mhyrzt/agentronics/README.md

# agentronics
Revisiting electronics and embedded systems with old sparks, new circuits, questionable ideas, and a few AI agents running around the lab with a suspicious amount of confidence.
