mhyrzt/agentronics/EEG/exports/previews/controller-header.png

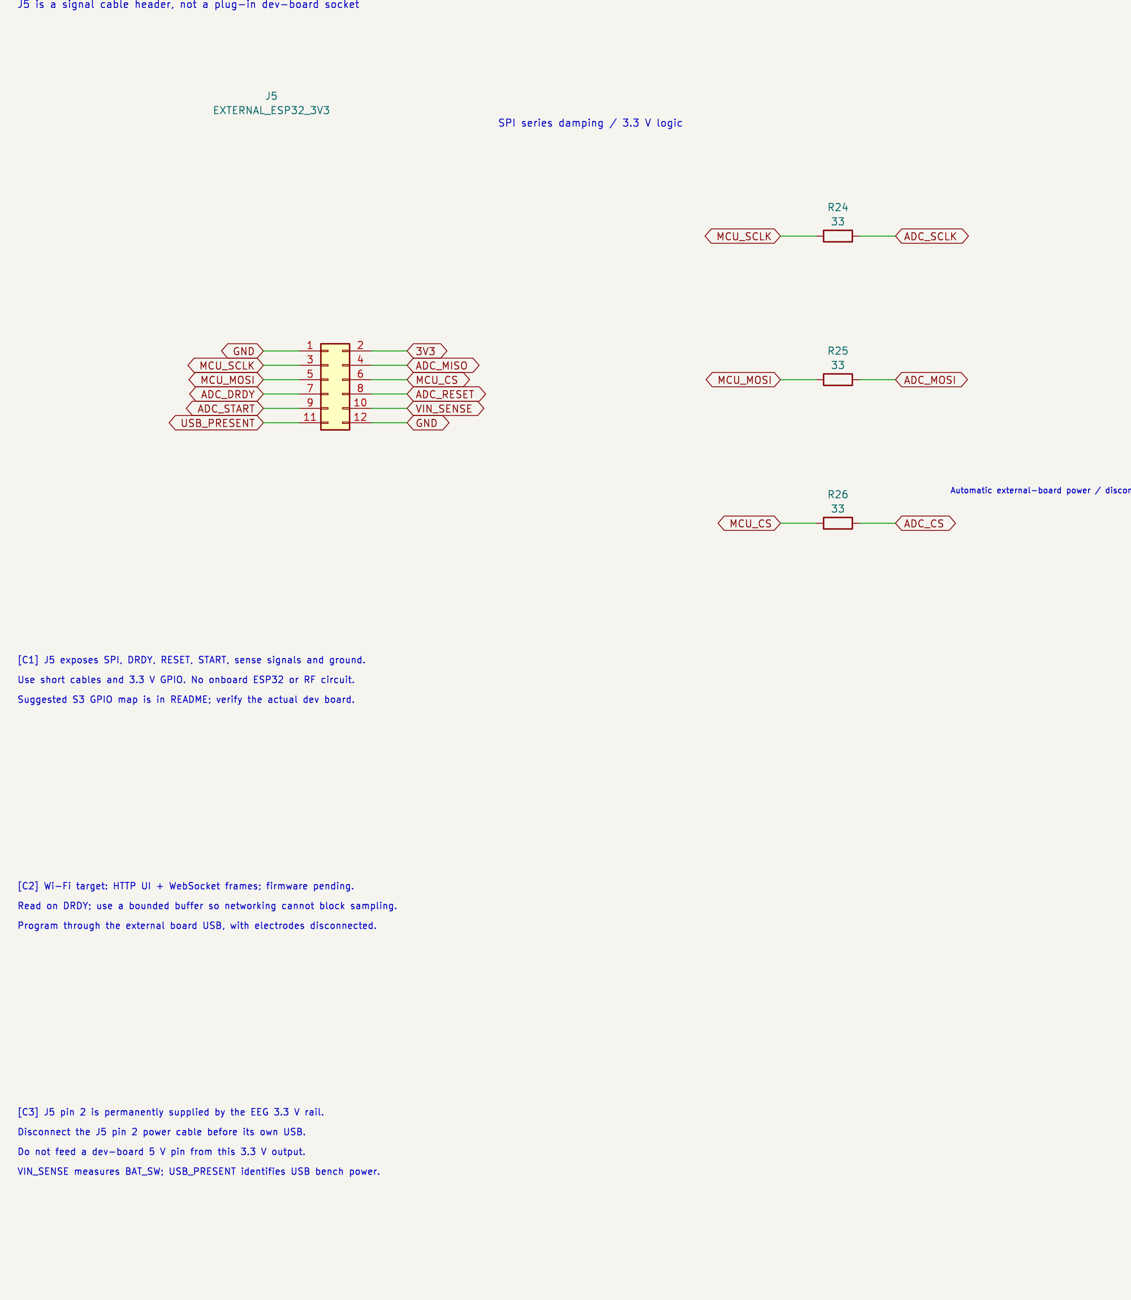
EEG/exports/previews/controller-header.png
