mhyrzt/agentronics/EEG/exports/previews/pcb-bottom.png

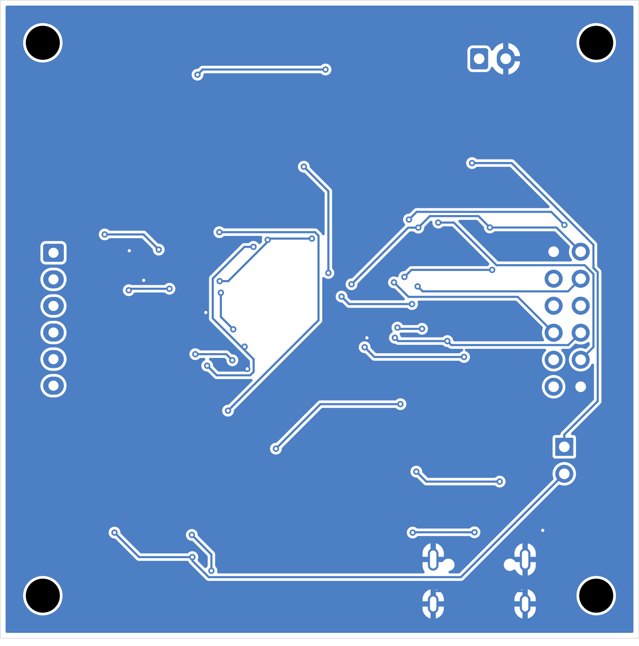
EEG/exports/previews/pcb-bottom.png
