mhyrzt/agentronics/EEG/exports/previews/pcb-top.png

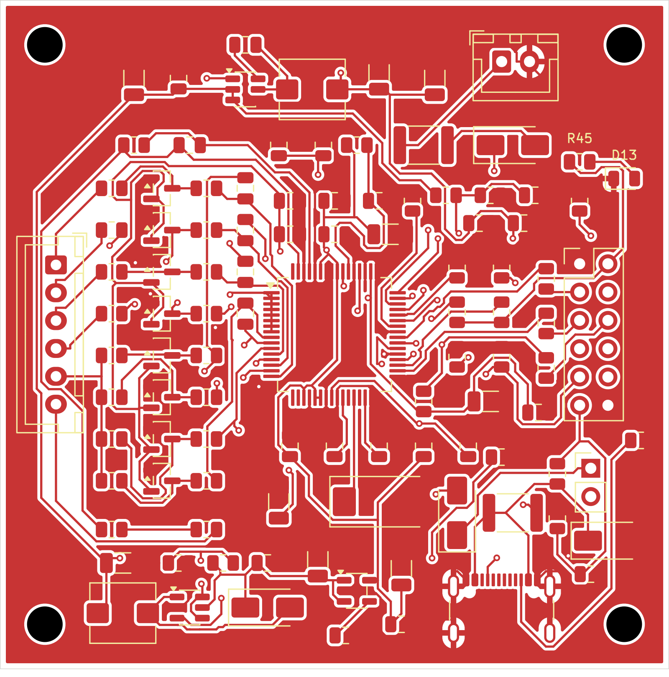
EEG/exports/previews/pcb-top.png
