mhyrzt/agentronics/EEG/exports/BOM.csv

References | Quantity | Value | Footprint | MPN | Manufacturer
C5 | 1 | 1n | Capacitor_SMD:C_0805_2012Metric | GRM21A5C1H102JA01D | Murata
C6 | 1 | 100u | Capacitor_Tantalum_SMD:CP_EIA-7343-31_Kemet-D | T491D107K010AT | KEMET
C34 | 1 | 10n | Capacitor_SMD:C_0805_2012Metric | GRM21A5C1H103JA01D | Murata
C1,C2,C3,C4 | 4 | 4.7n | Capacitor_SMD:C_0805_2012Metric | GRM21A5C1H472JA01D | Murata
C11,C19,C24,C28,C33,C35,C37 | 7 | 10u | Capacitor_SMD:C_1206_3216Metric | GRM31CR71C106KA12L | Murata
C31,C32 | 2 | 22u | Capacitor_SMD:C_1206_3216Metric | GRM31CR61E226KE15L | Murata
C10,C13,C14,C15,C16,C17,C18,C21,C38,C7,C8 | 11 | 1u | Capacitor_SMD:C_0805_2012Metric | GRM21BR71E105KA99L | Murata
C12,C20,C22,C25,C27,C29,C30,C36,C40,C9 | 10 | 100n | Capacitor_SMD:C_0805_2012Metric | GRM21BR71H104KA01L | Murata
D12 | 1 | SMAJ5.0A | Diode_SMD:D_SMA | SMAJ5.0A | Diodes Incorporated
D13 | 1 | PWR_GREEN | LED_SMD:LED_0805_2012Metric | APT2012LZGCK | Kingbright
D1,D2,D3,D4,D5,D7,D8,D9 | 8 | BAV199 | Package_TO_SOT_SMD:SOT-23 | BAV199,215 | Nexperia
D10,D11,D6 | 3 | SS14 | Diode_SMD:D_SMA | SS14 | Diodes Incorporated
F1,F2 | 2 | 0.75A_PTC | Fuse:Fuse_1812_4532Metric | 1812L075/24DR | Littelfuse
J1 | 1 | ELECTRODES | Connector_JST:JST_XH_B6B-XH-A_1x06_P2.50mm_Vertical | B6B-XH-A | JST
J2 | 1 | 2S_BATTERY | Connector_JST:JST_XH_B2B-XH-A_1x02_P2.50mm_Vertical | B2B-XH-A | JST
J4 | 1 | POWER_ENABLE | Connector_PinHeader_2.54mm:PinHeader_1x02_P2.54mm_Vertical | 61300211121 | Wurth Elektronik
J5 | 1 | EXTERNAL_ESP32_3V3 | Connector_PinHeader_2.54mm:PinHeader_2x06_P2.54mm_Vertical | 61301221121 | Wurth Elektronik
J6 | 1 | USB_C_BENCH_POWER | Connector_USB:USB_C_Receptacle_GCT_USB4105-xx-A_16P_TopMnt_Horizontal | USB4105-GF-A | GCT
L1,L2 | 2 | 4.7uH | Inductor_SMD:L_Bourns_SRP5030T | SRP5030T-4R7M | Bourns
R13 | 1 | 1M | Resistor_SMD:R_0805_2012Metric | RC0805FR-071ML | Yageo
R14 | 1 | 0 | Resistor_SMD:R_0805_2012Metric | RC0805JR-070RL | Yageo
R41 | 1 | 442k | Resistor_SMD:R_0805_2012Metric | RC0805FR-07442KL | Yageo
R45 | 1 | 1k | Resistor_SMD:R_0805_2012Metric | RC0805FR-071KL | Yageo
R1,R10,R19,R2,R20,R23,R3,R33,R34,R35,R36,R37,R38,R4,R42,R5,R6,R7,R8,R9 | 20 | 10k | Resistor_SMD:R_0805_2012Metric | RC0805FR-0710KL | Yageo
R11,R12 | 2 | 499k | Resistor_SMD:R_0805_2012Metric | RC0805FR-07499KL | Yageo
R15,R16,R17,R18,R21,R22,R32,R44 | 8 | 100k | Resistor_SMD:R_0805_2012Metric | RC0805FR-07100KL | Yageo
R24,R25,R26 | 3 | 33 | Resistor_SMD:R_0805_2012Metric | RC0805FR-0733RL | Yageo
R31,R43 | 2 | 330k | Resistor_SMD:R_0805_2012Metric | RC0805FR-07330KL | Yageo
R39,R40 | 2 | 5.1k | Resistor_SMD:R_0805_2012Metric | RC0805FR-075K1L | Yageo
U1 | 1 | ADS1299-4 | Package_QFP:TQFP-64_10x10mm_P0.5mm | ADS1299-4PAG | Texas Instruments
U3 | 1 | AP63203WU-7 | Package_TO_SOT_SMD:TSOT-23-6 | AP63203WU-7 | Diodes Incorporated
U4 | 1 | LP2985AIM5-5.0/NOPB | Package_TO_SOT_SMD:SOT-23-5 | LP2985AIM5-5.0/NOPB | Texas Instruments
U5 | 1 | AP3031KTR-G1 | Package_TO_SOT_SMD:SOT-23-6 | AP3031KTR-G1 | Diodes Incorporated
