mhyrzt/agentronics/EEG/exports/previews/pcb-assembly.png

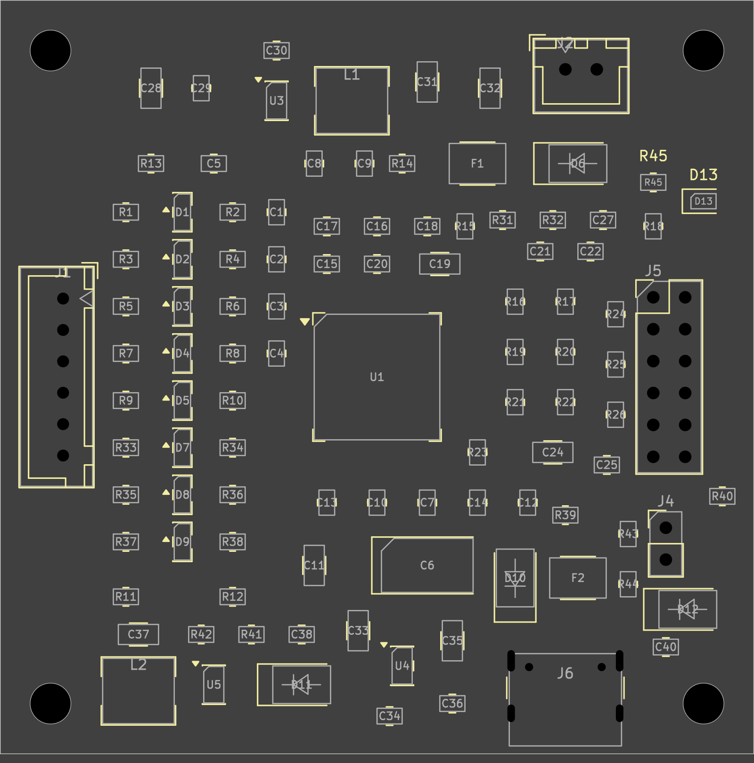
EEG/exports/previews/pcb-assembly.png
