mhyrzt/agentronics/EEG/exports/schematic.pdf

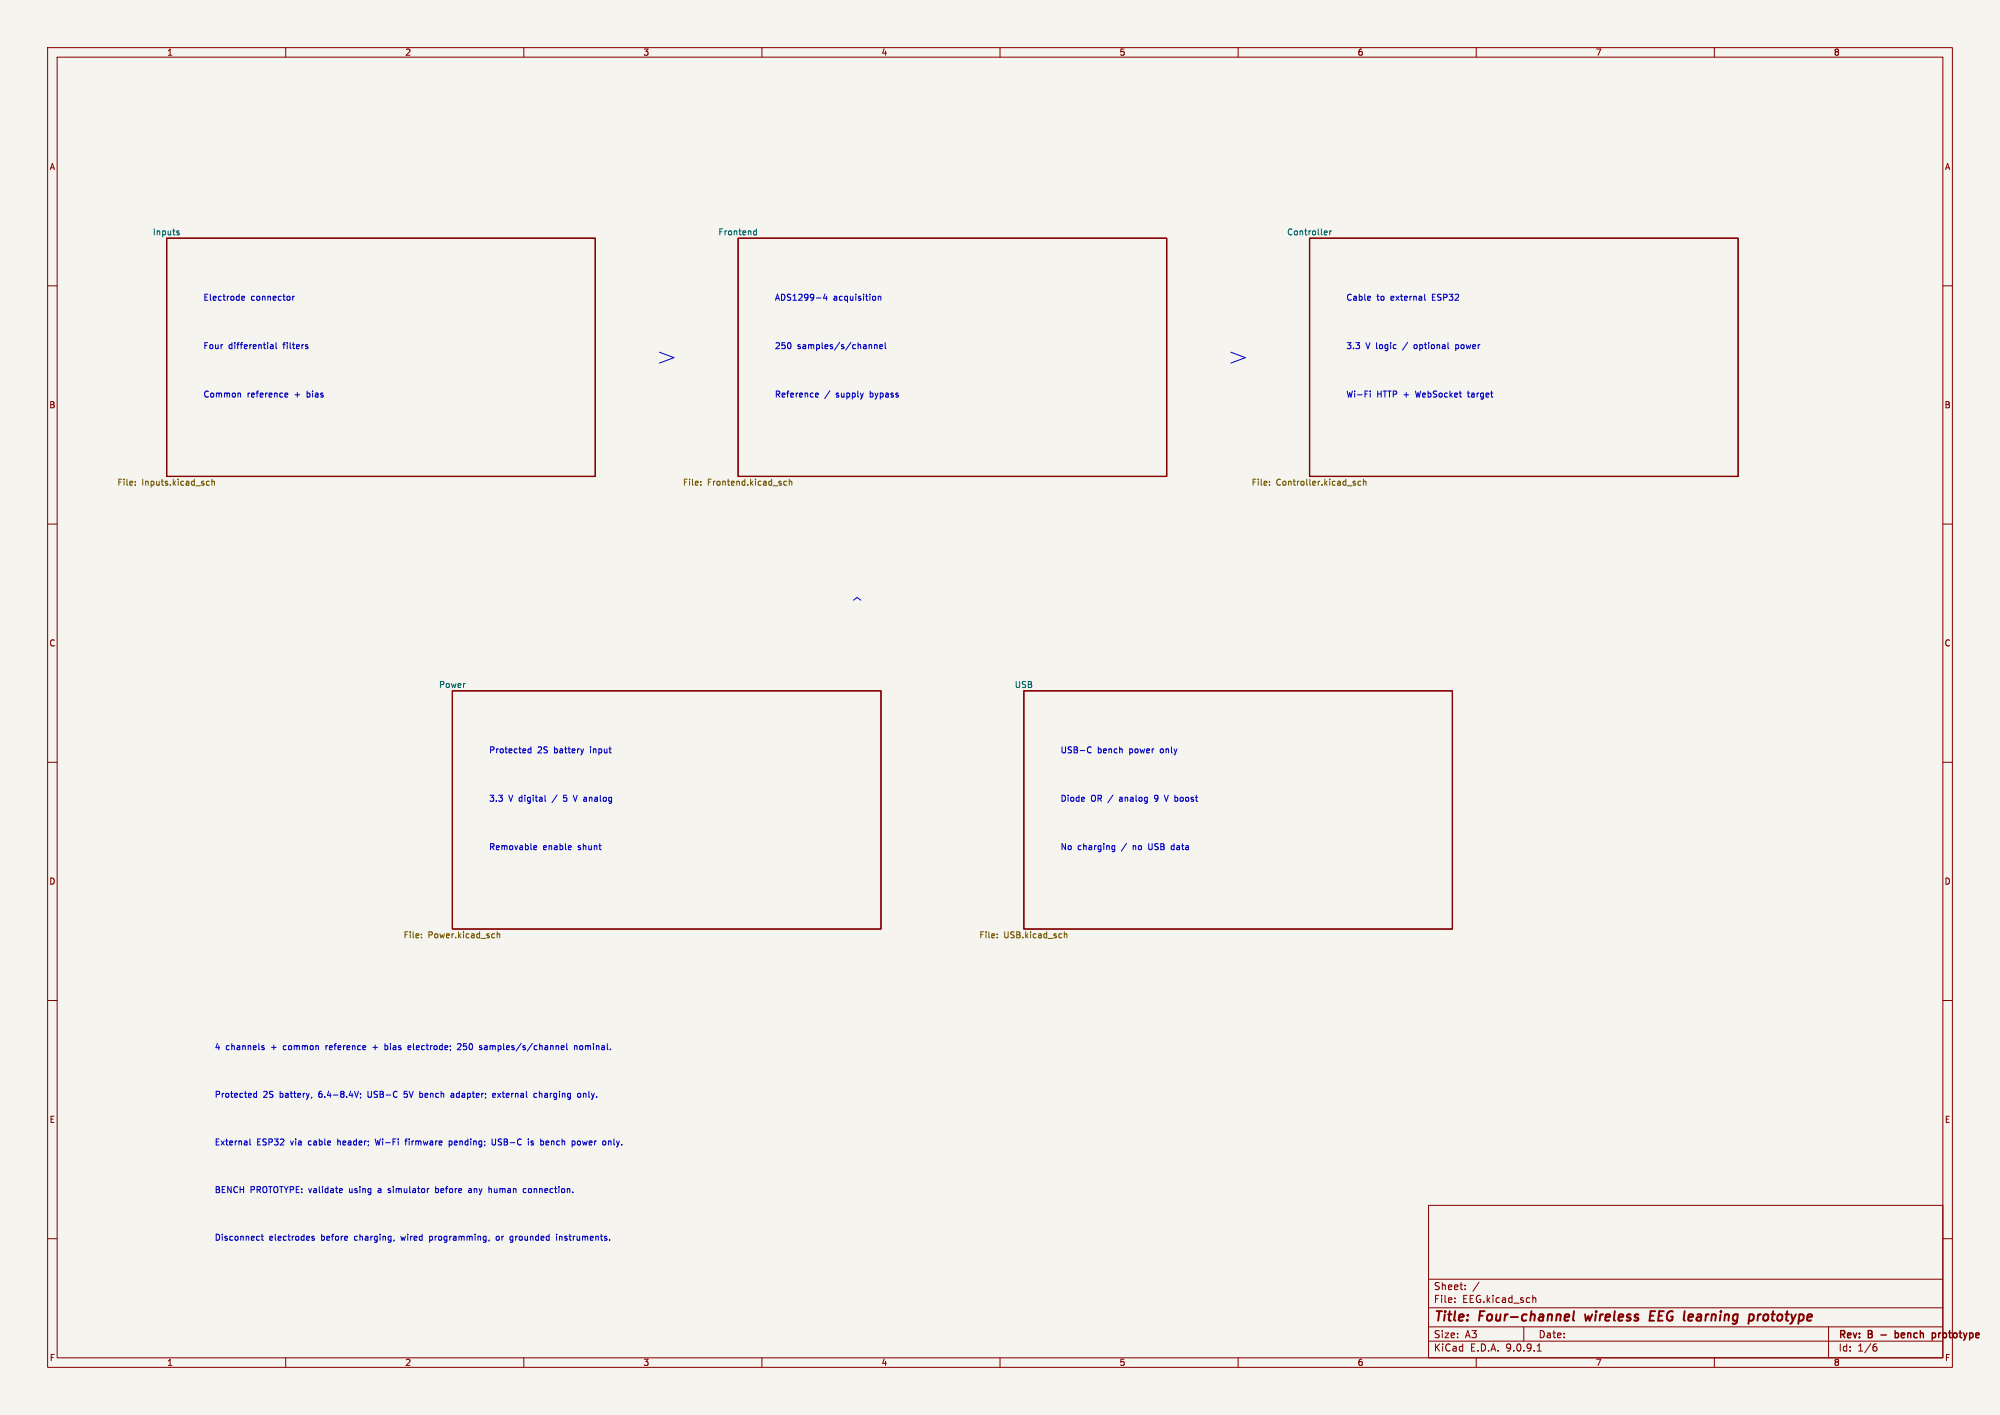
[picture p20: page 1]

File: USB.kicad_sch Power File: Power.kicad_sch

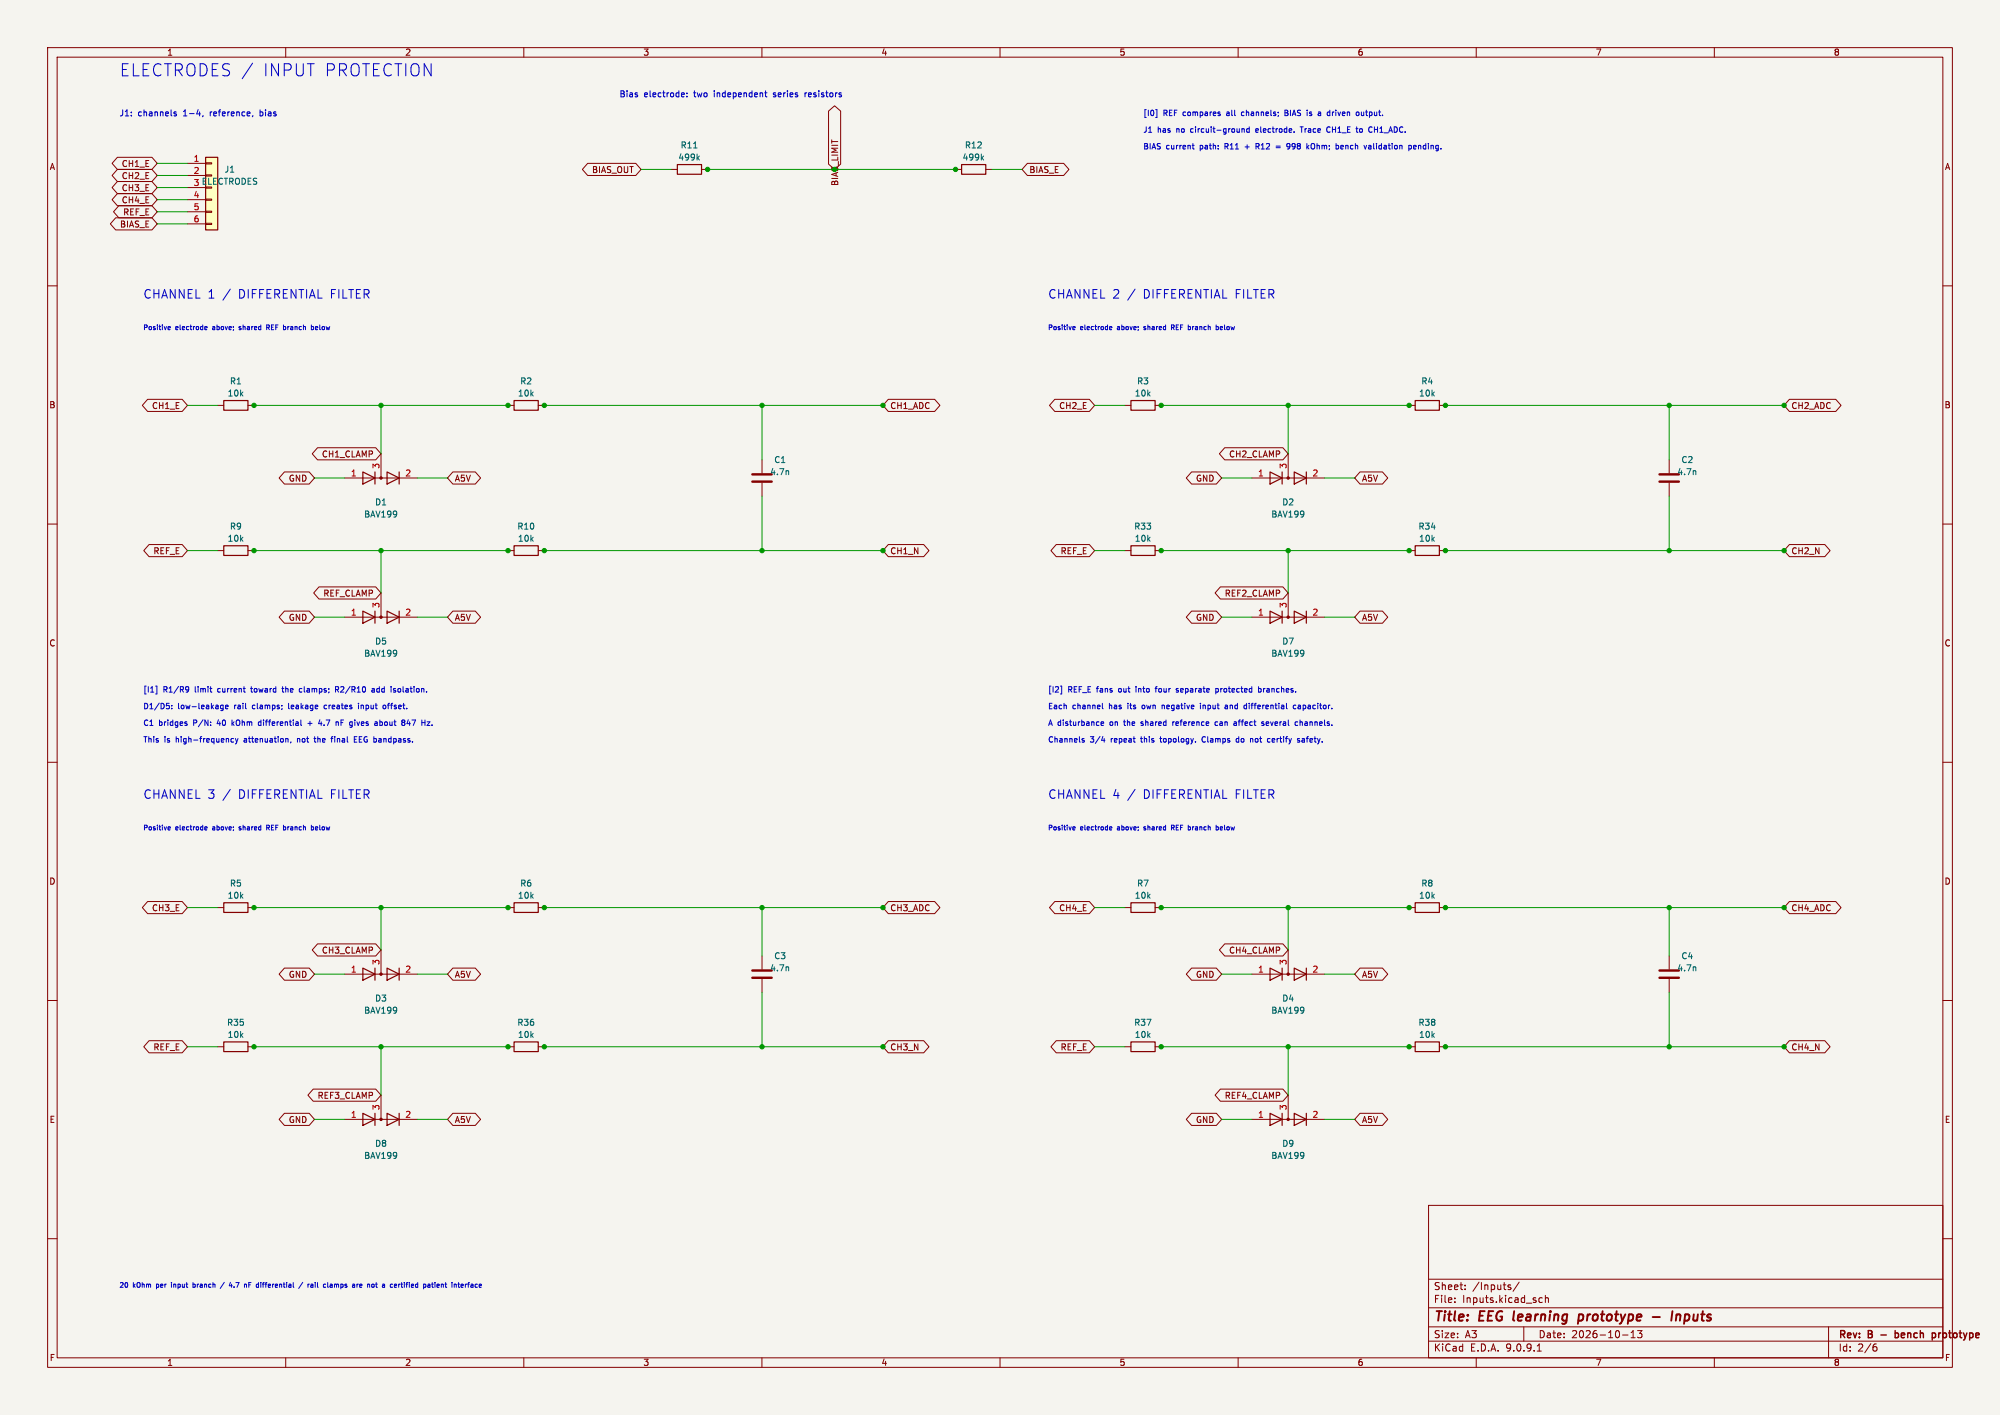
[picture p21: page 2]

Id: 2/6 Title: EEG learning prototype - Inputs

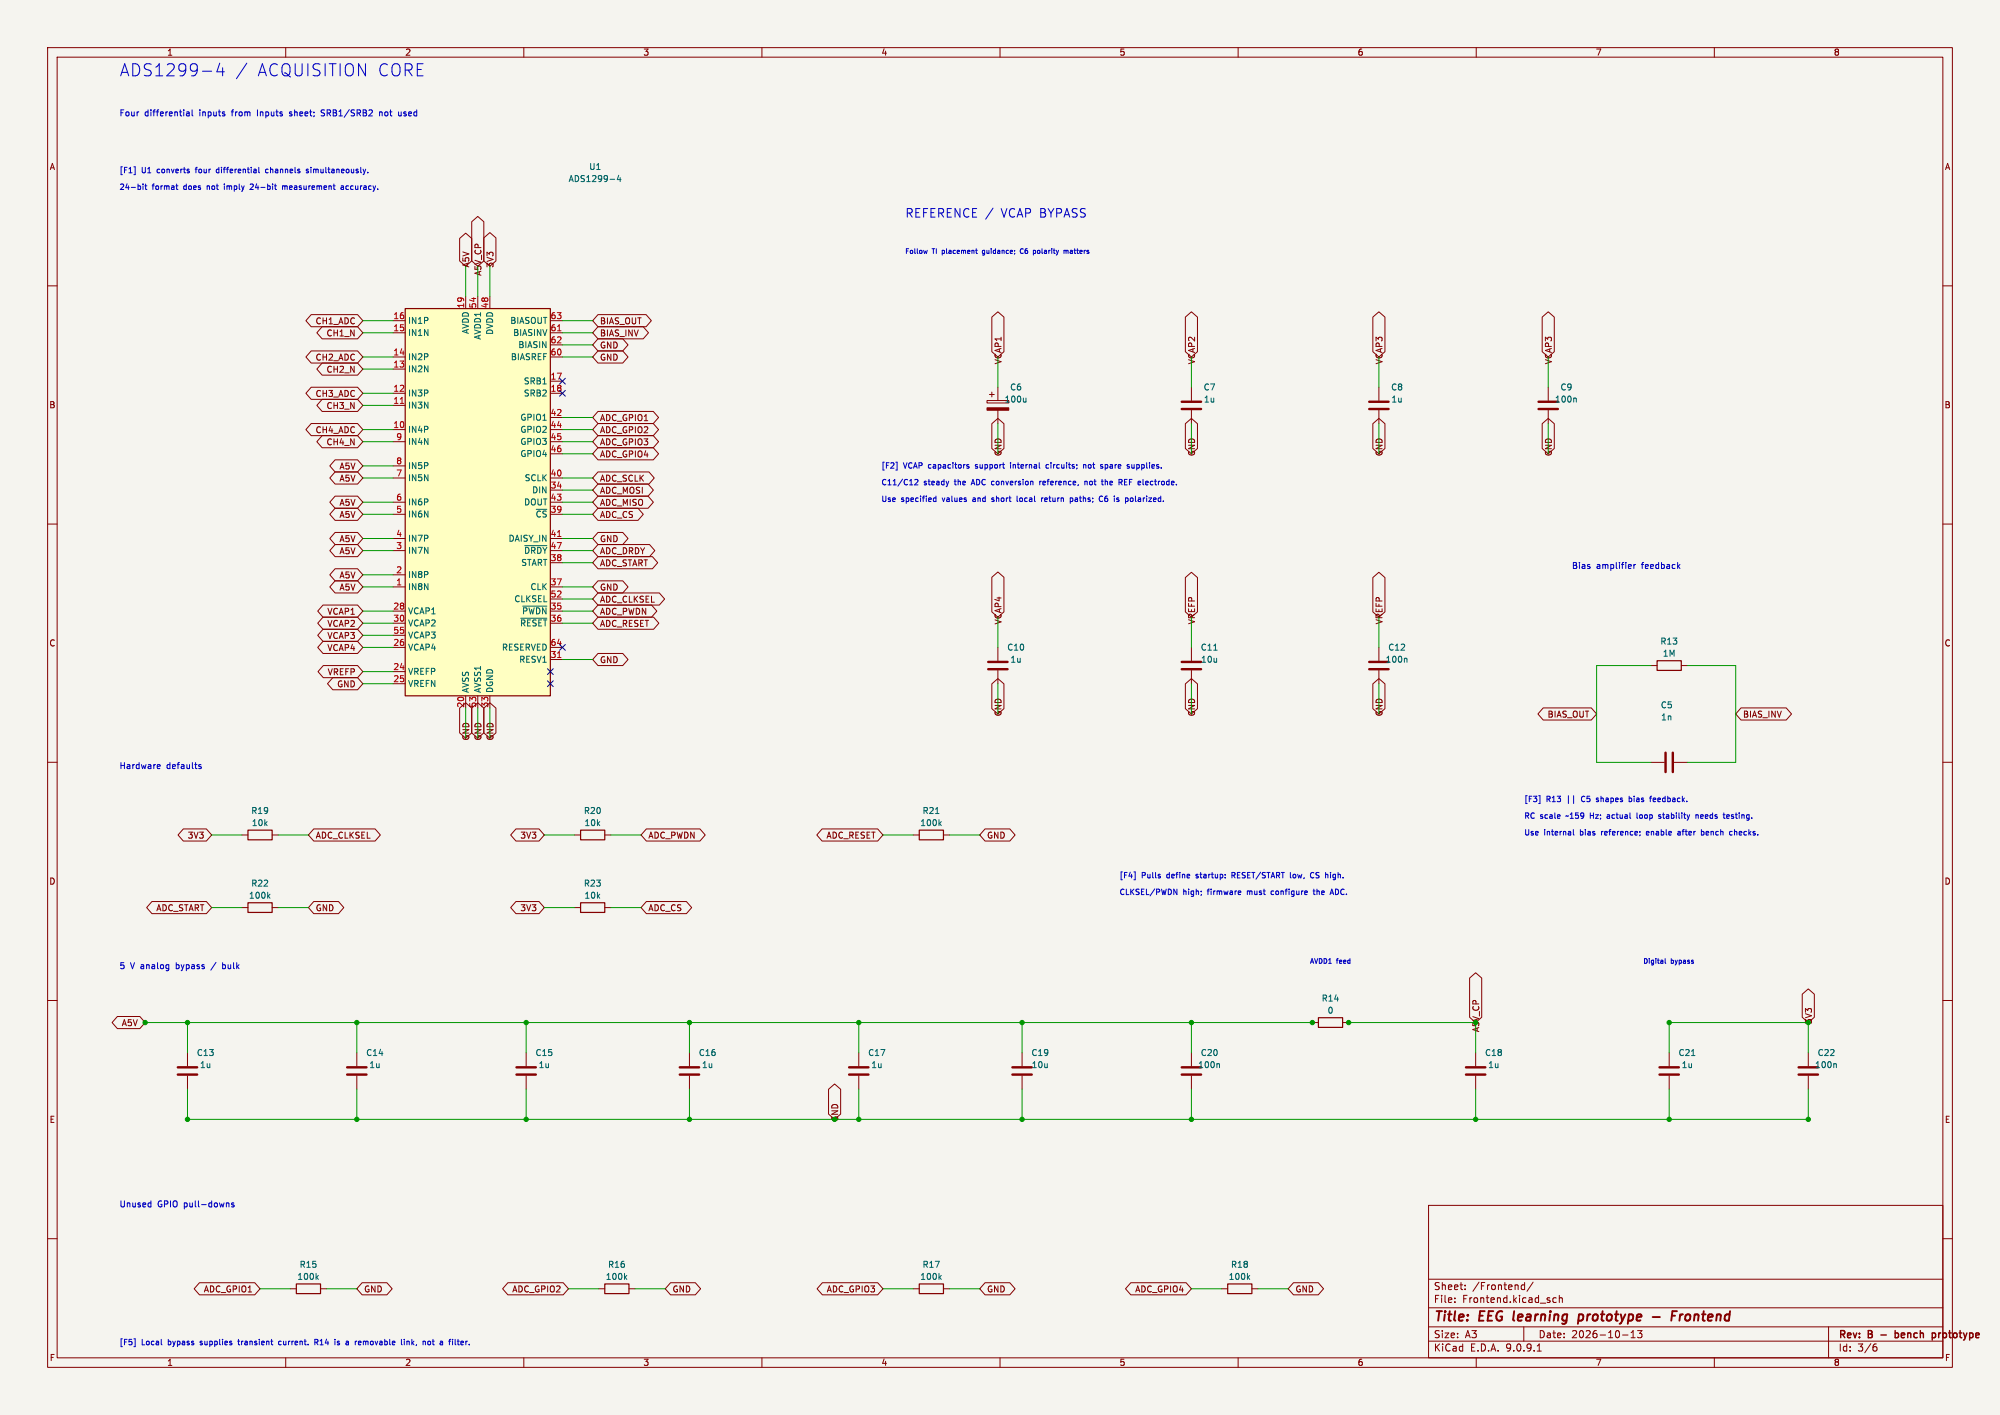
[picture p22: page 3]

Unused GPIO pull-downs

Id: 3/6 Title: EEG learning prototype - Frontend

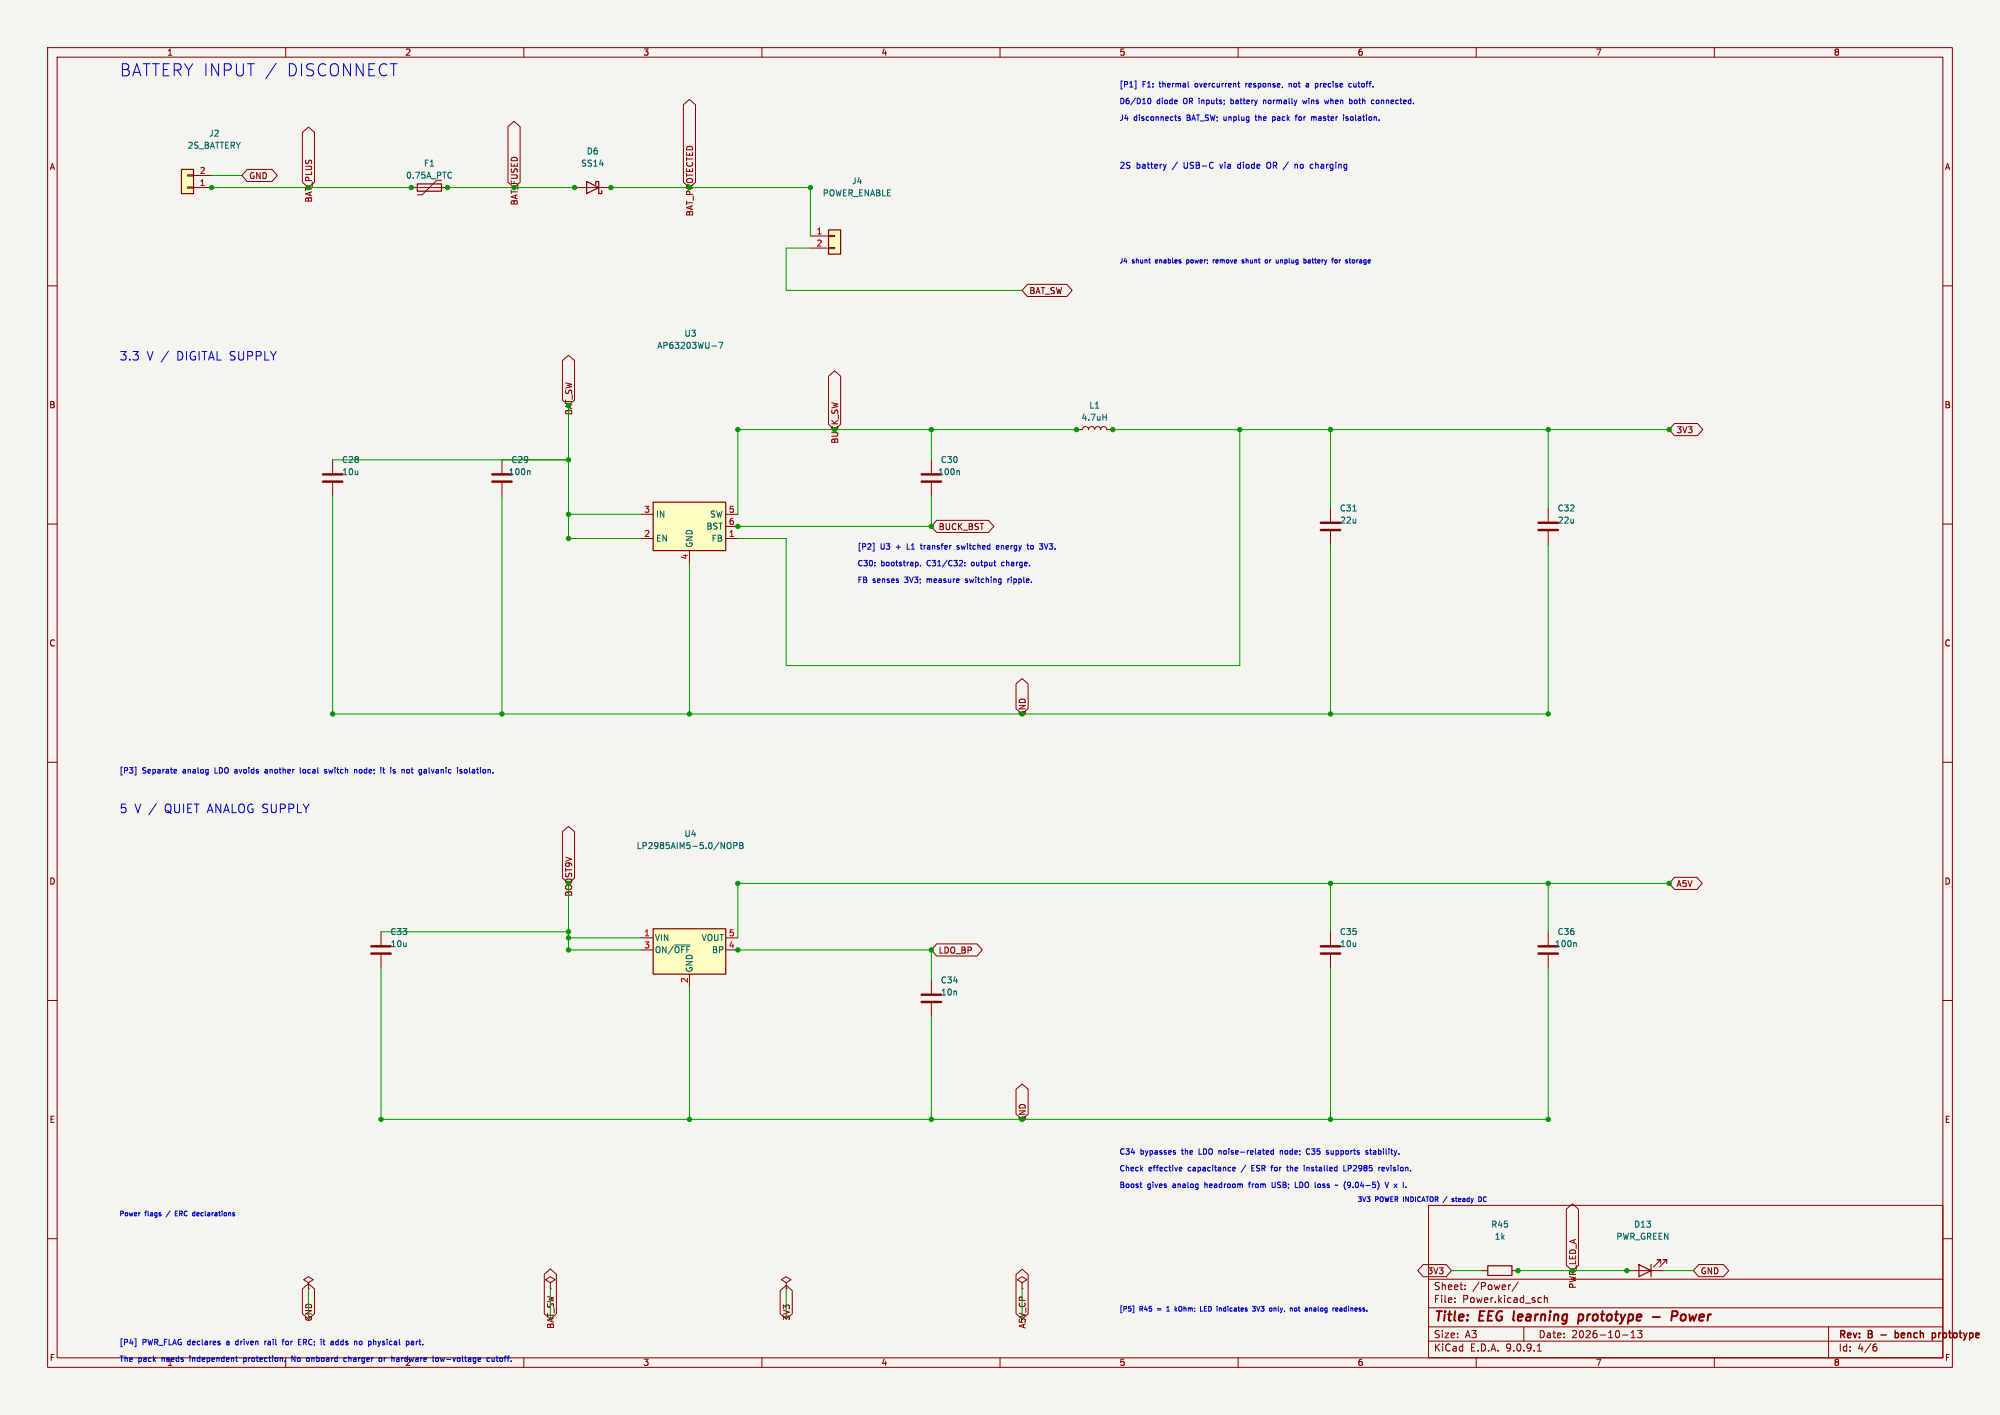
[picture p23: page 4]

2S battery / USB-C via diode OR / no charging

J4 shunt enables power; remove shunt or unplug battery for storage

Power flags / ERC declarations

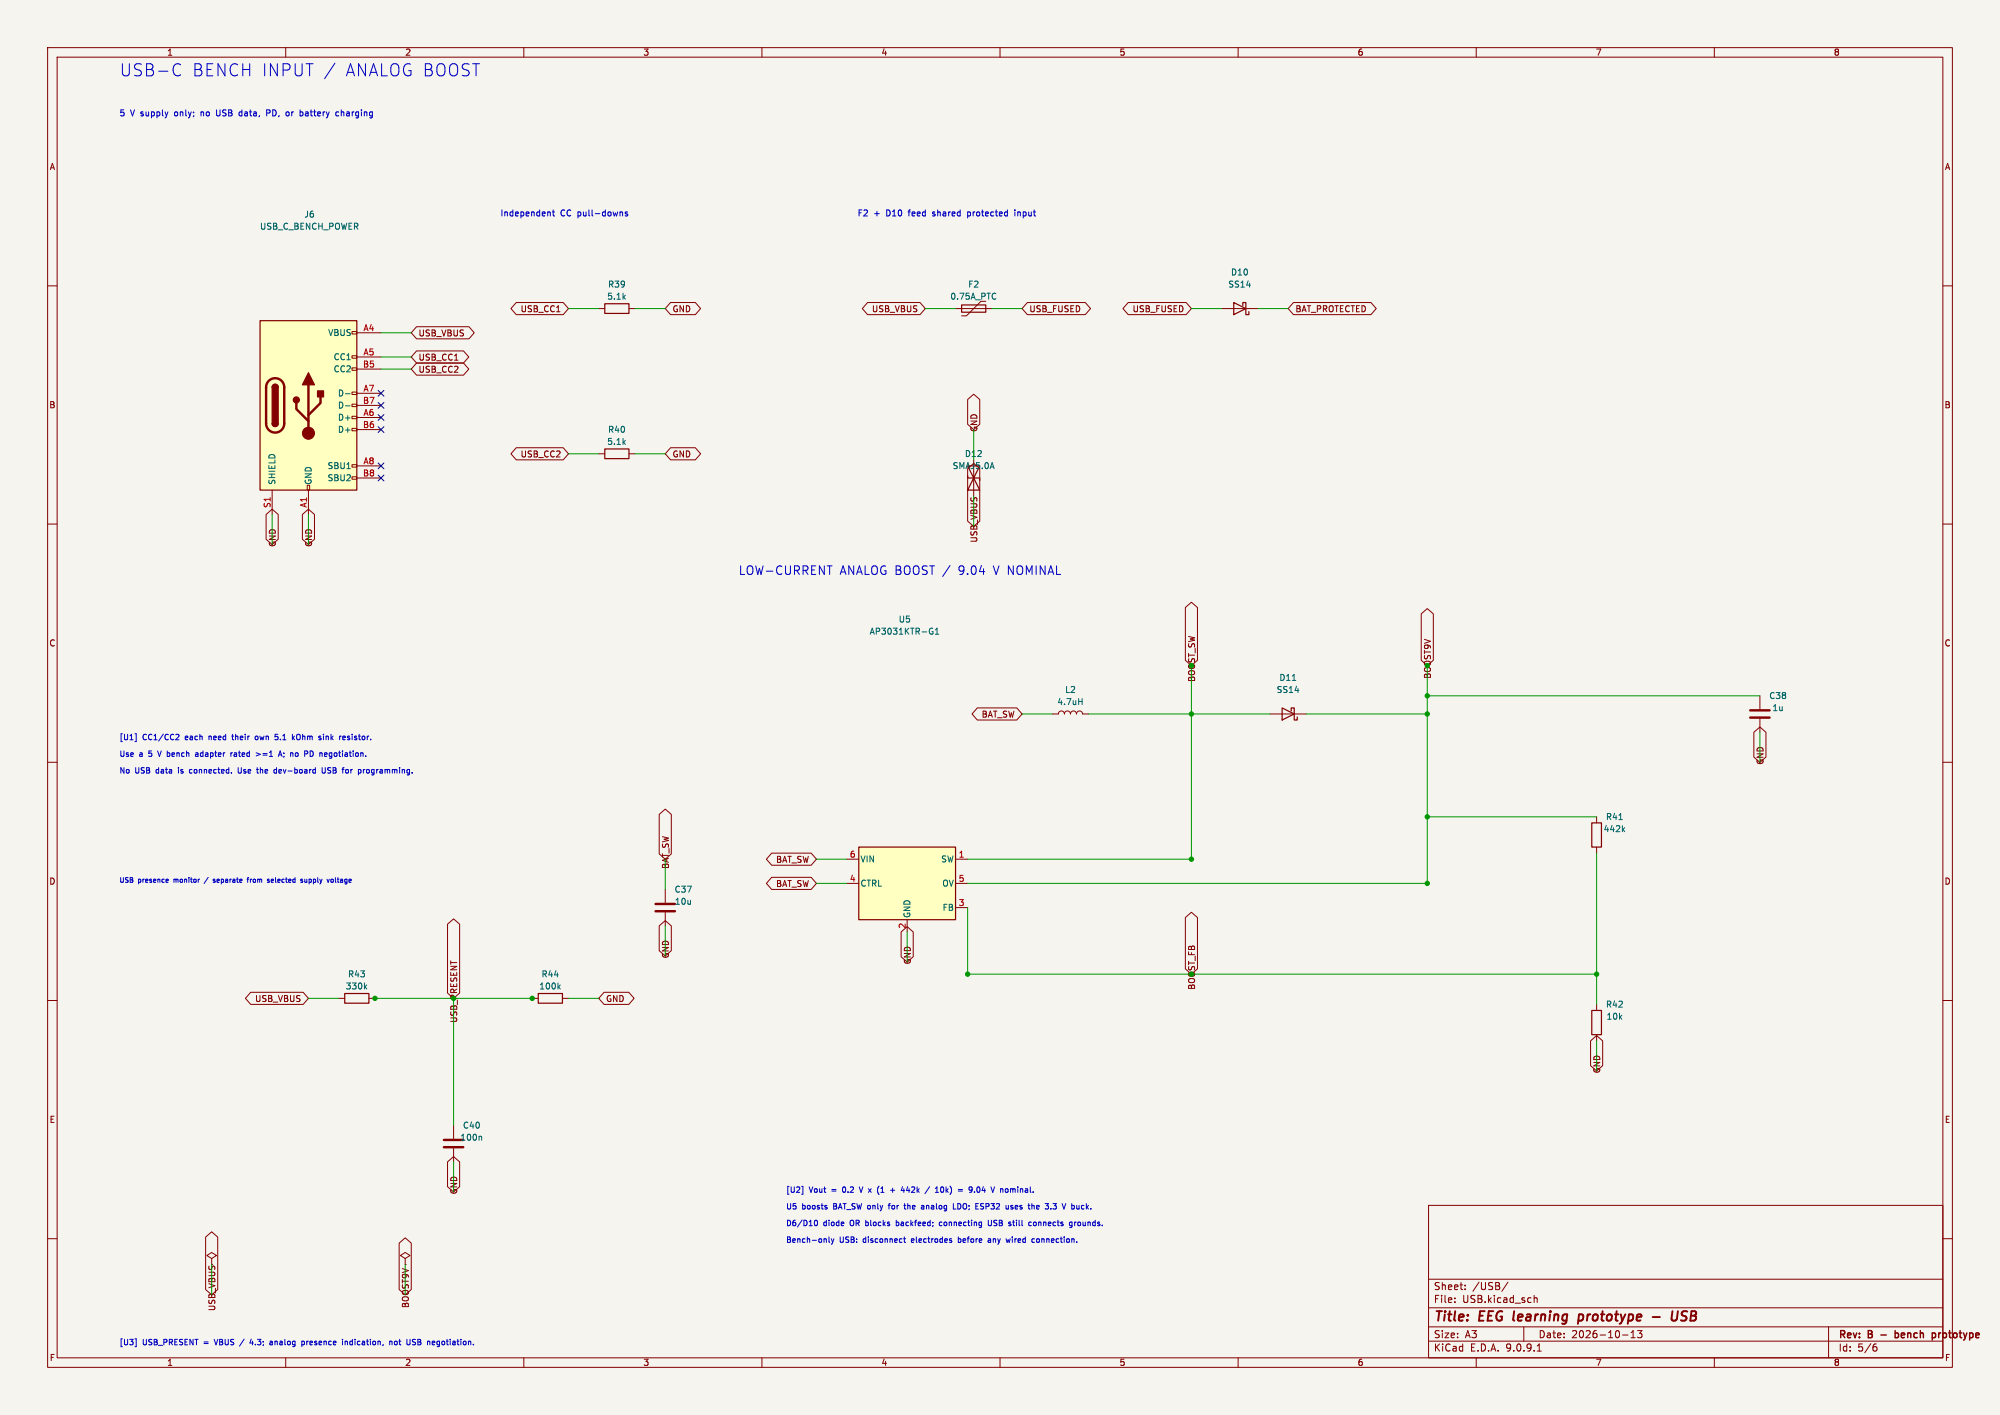
[picture p24: page 5]

USB-C BENCH INPUT / ANALOG BOOST

5 V supply only; no USB data, PD, or battery charging

File: USB.kicad_sch Sheet: /USB/
Id: 5/6 Title: EEG learning prototype - USB

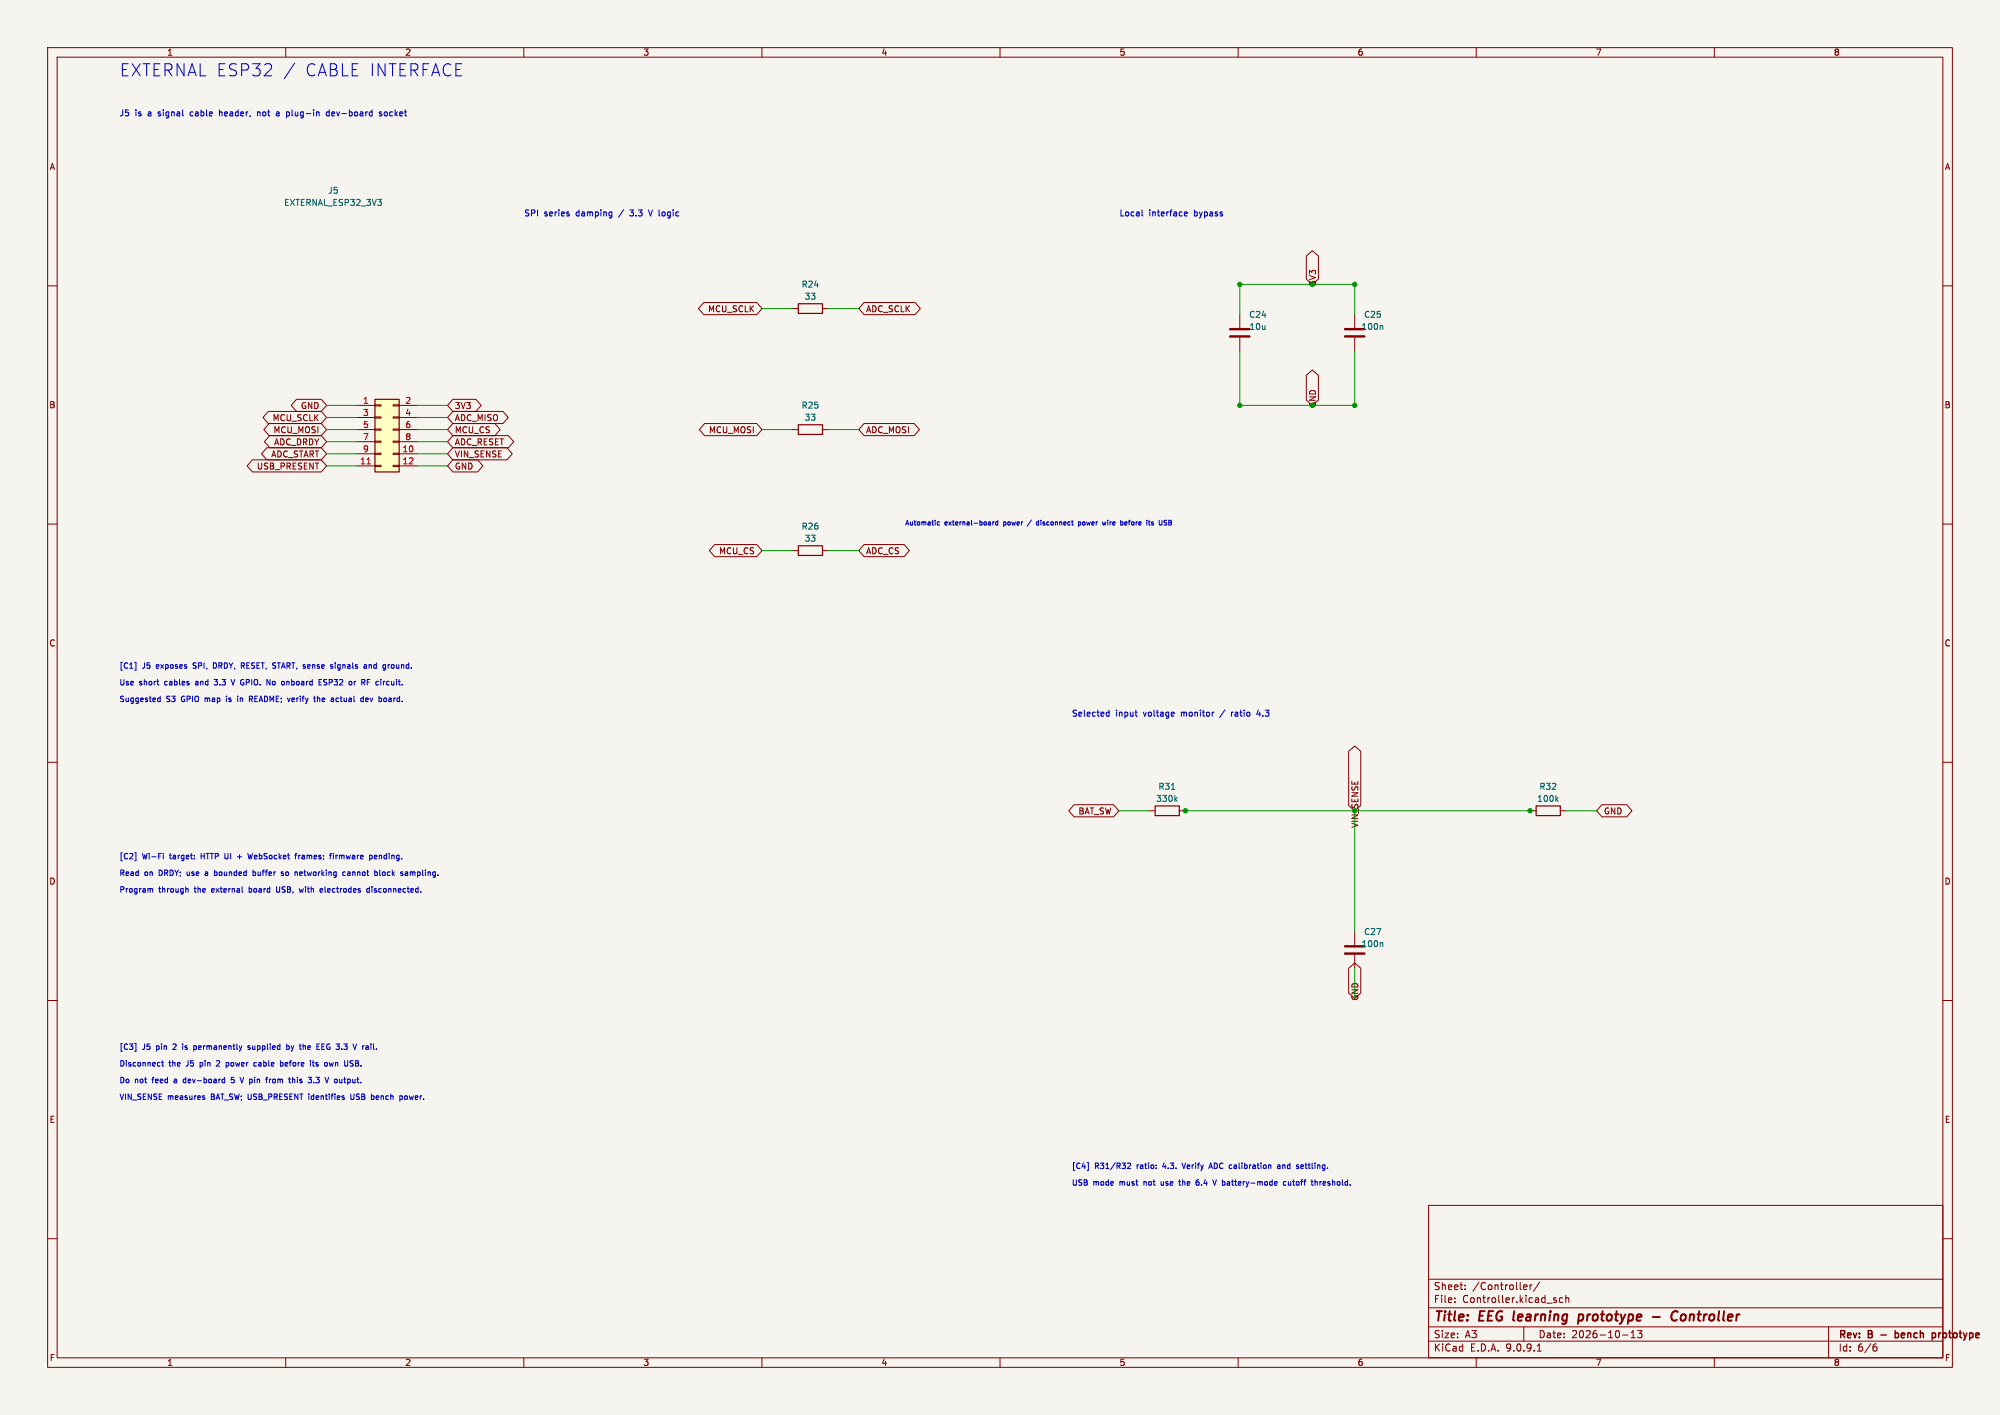
[picture p25: page 6]

SPI series damping / 3.3 V logic

Id: 6/6 Title: EEG learning prototype - Controller File: Controller.kicad_sch Sheet: /Controller/
