mhyrzt/agentronics/EEG/exports/assembly.pdf

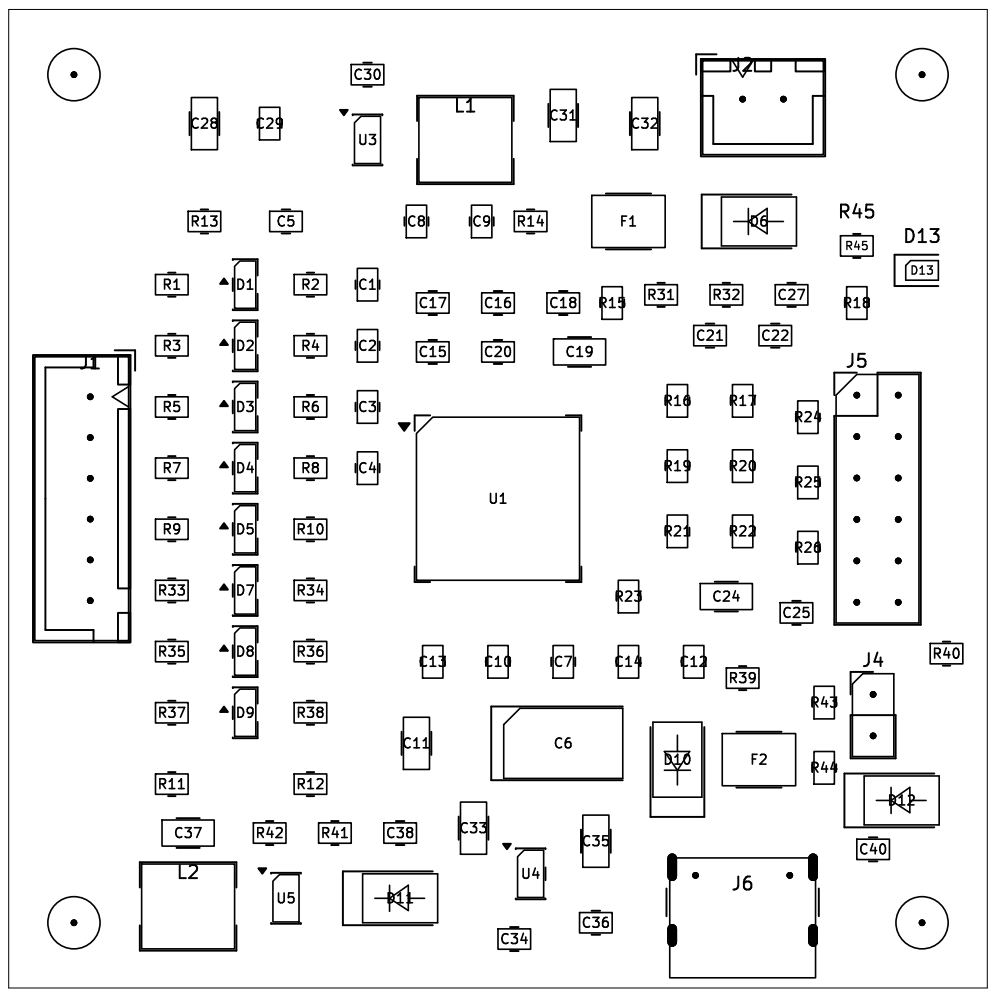
[picture p26: page 1]
