mhyrzt/agentronics/EEG/hardware/EEG.kicad_pcb

## KiCad design EEG/hardware/EEG.kicad_pcb (2026-10-13)

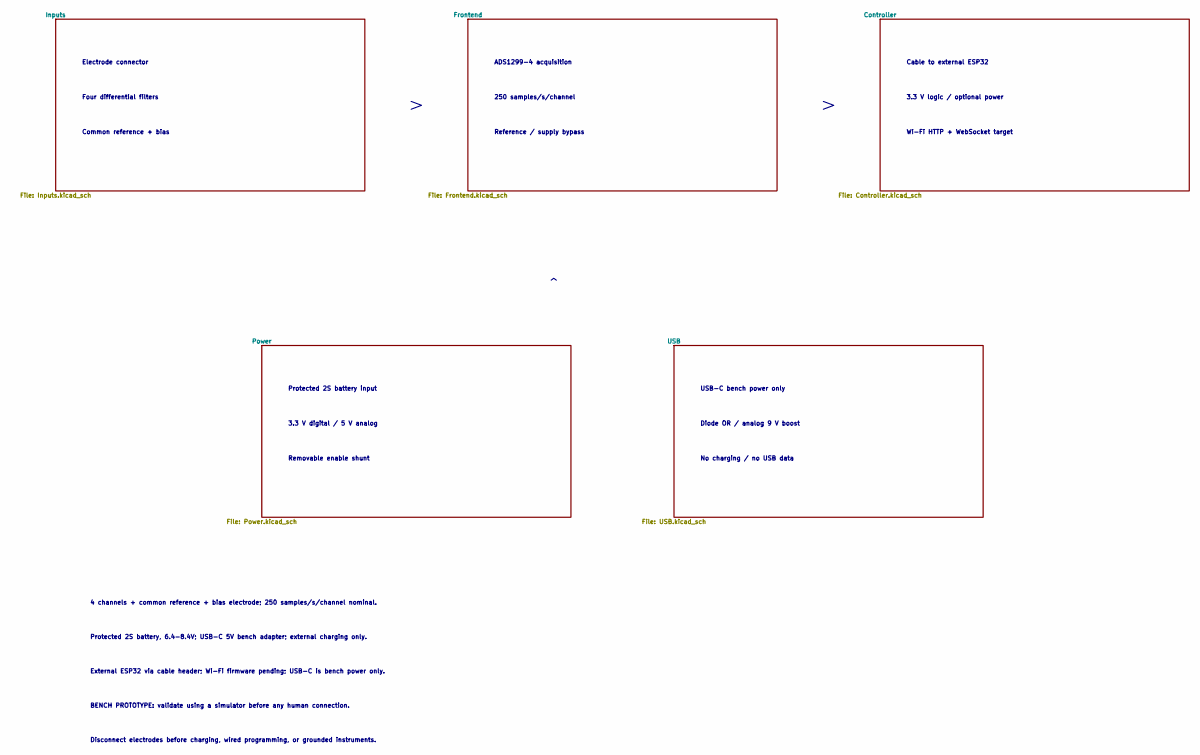
[picture p27: schematic EEG.kicad_sch, Four-channel wireless EEG learning prototype]

Notes on the sheet:
Electrode connector
Four differential filters
Common reference + bias
ADS1299-4 acquisition
250 samples/s/channel
Reference / supply bypass
Protected 2S battery input
3.3 V digital / 5 V analog
Removable enable shunt
USB-C bench power only
Diode OR / analog 9 V boost
No charging / no USB data
Cable to external ESP32
3.3 V logic / optional power
Wi-Fi HTTP + WebSocket target
4 channels + common reference + bias electrode; 250 samples/s/channel nominal.
Protected 2S battery, 6.4-8.4V; USB-C 5V bench adapter; external charging only.
External ESP32 via cable header; Wi-Fi firmware pending; USB-C is bench power only.
BENCH PROTOTYPE: validate using a simulator before any human connection.
Disconnect electrodes before charging, wired programming, or grounded instruments.

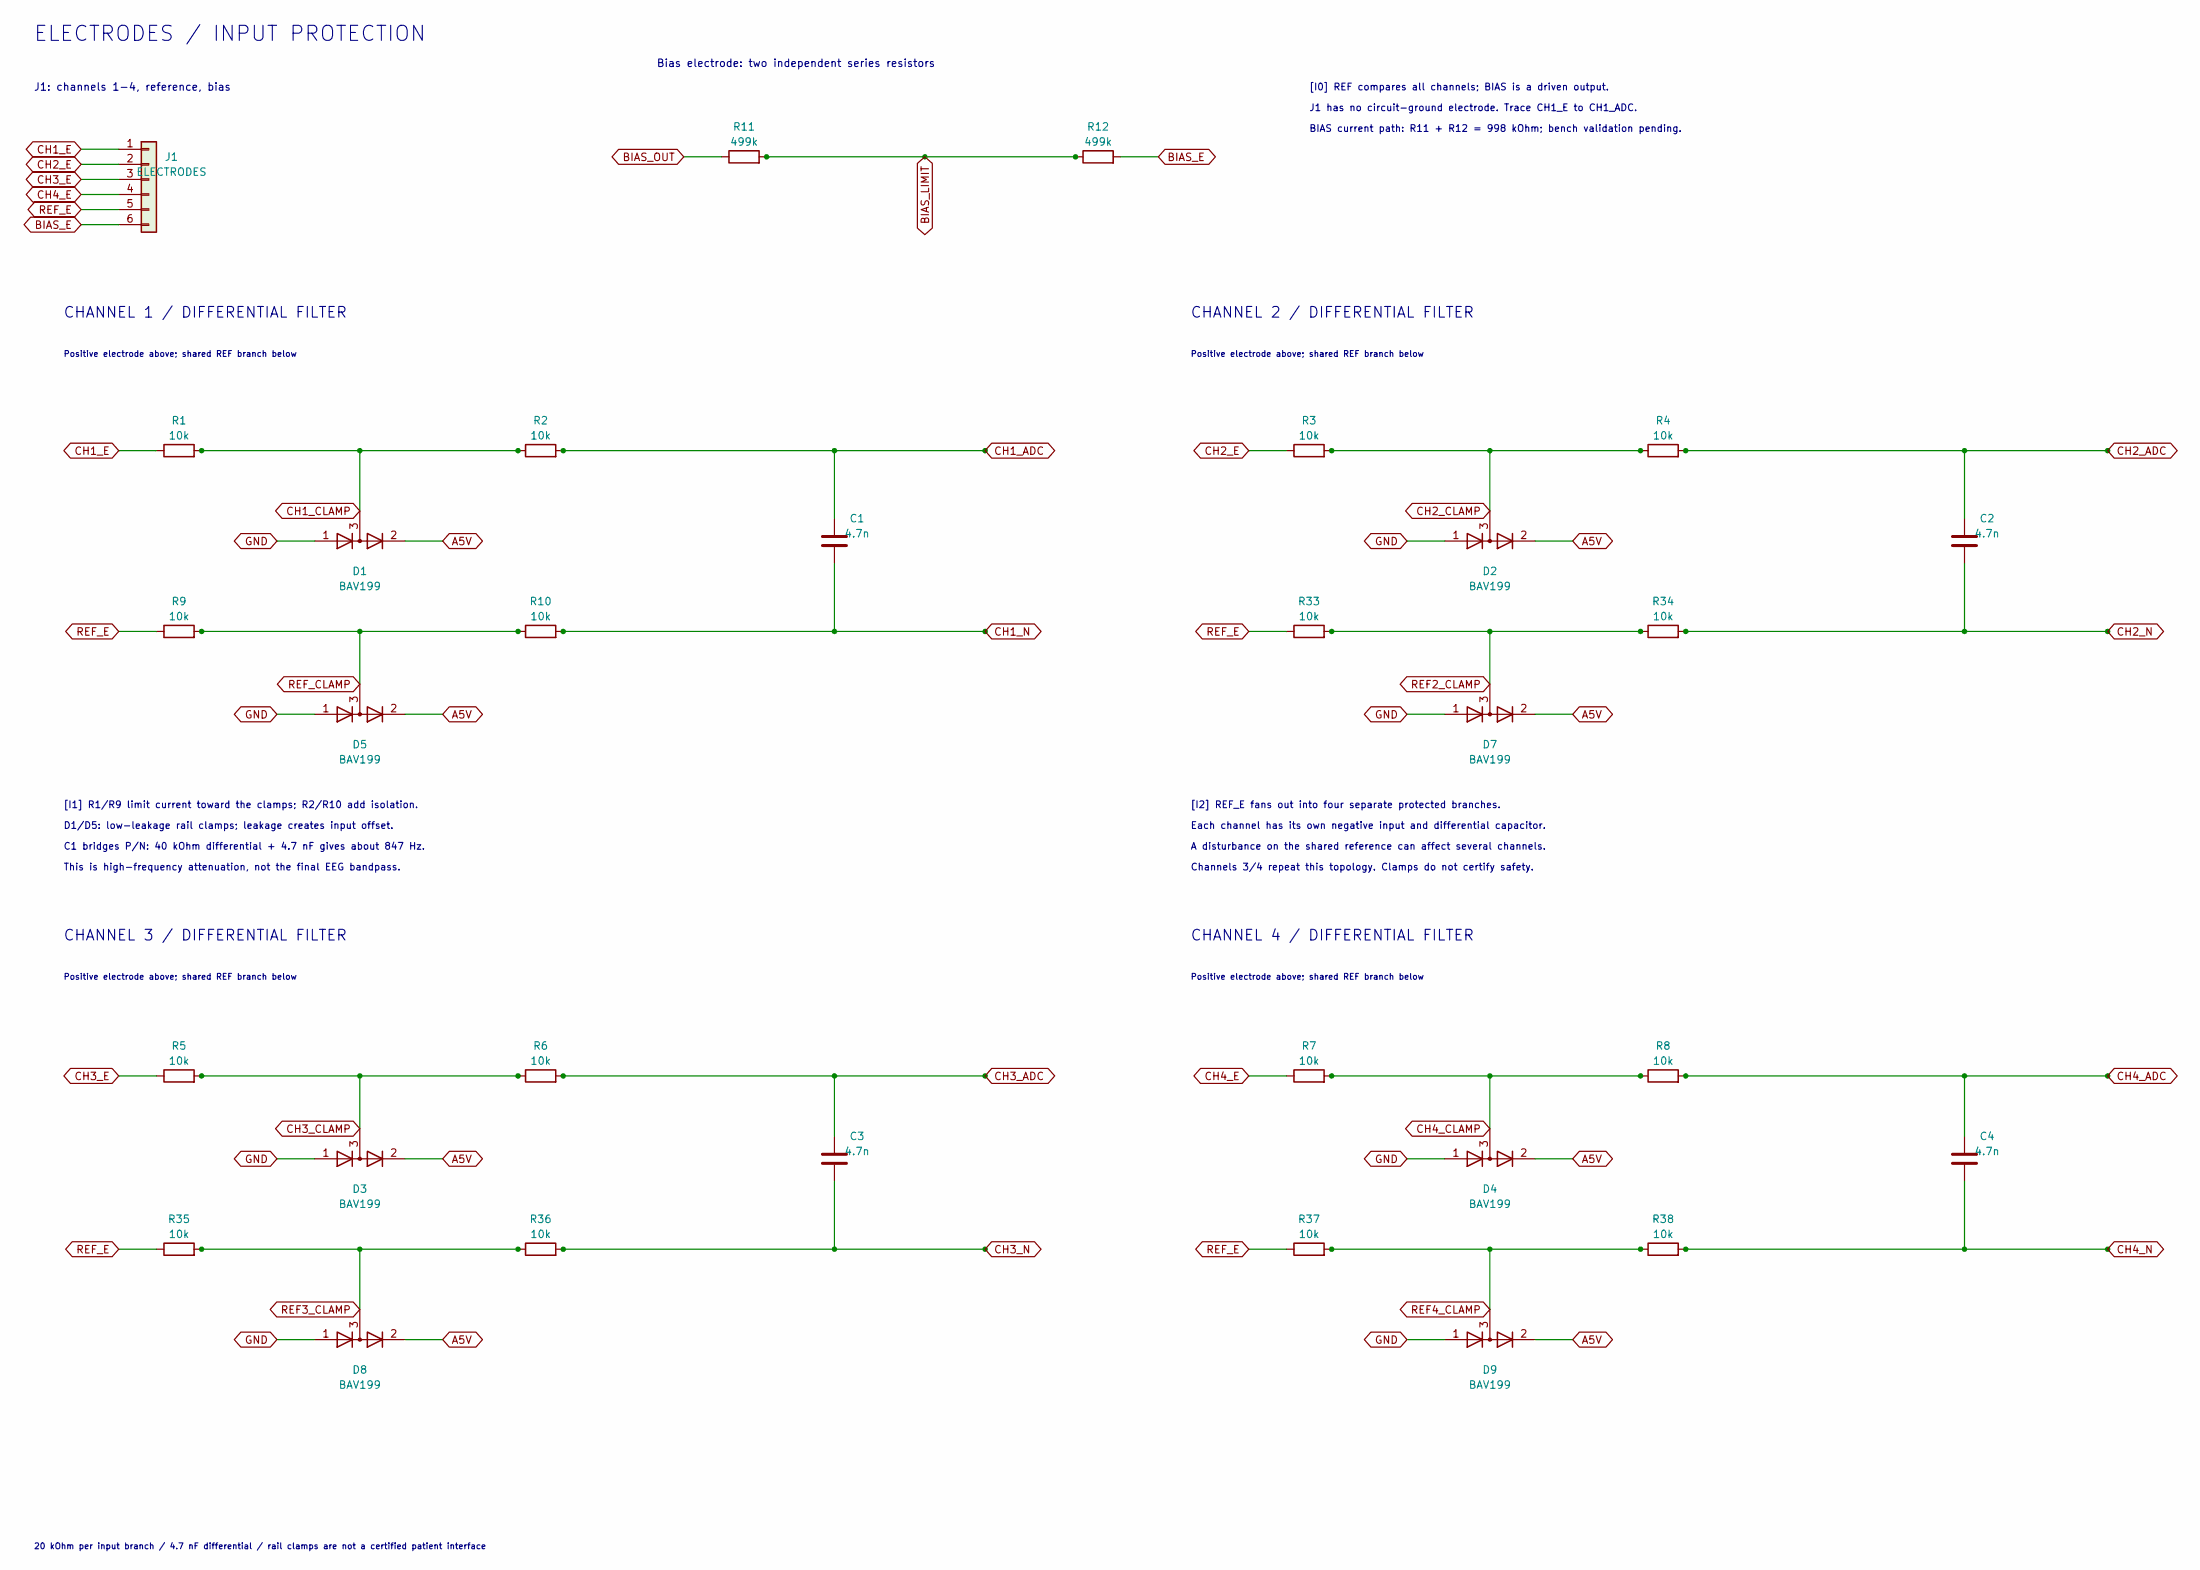
[picture p28: schematic Inputs.kicad_sch, EEG learning prototype - Inputs]

Parts:
C1, C2, C3, C4: 4.7n; C_0805_2012Metric; MPN GRM21A5C1H472JA01D
D1, D2, D3, D4, D5, D7, D8, D9: BAV199; SOT-23; MPN BAV199,215
J1: ELECTRODES; JST_XH_B6B-XH-A_1x06_P2.50mm_Vertical; MPN B6B-XH-A
R1, R2, R3, R4, R5, R6, R7, R8, R9, R10, R33, R34, R35, R36, R37, R38: 10k; R_0805_2012Metric; MPN RC0805FR-0710KL
R11, R12: 499k; R_0805_2012Metric; MPN RC0805FR-07499KL

Connections:
A5V: D1.2 (K2), D2.2 (K2), D3.2 (K2), D4.2 (K2), D5.2 (K2), D7.2 (K2), D8.2 (K2), D9.2 (K2); also elsewhere on the board
BIAS_E: J1.6, R12.2
BIAS_LIMIT: R11.2, R12.1
BIAS_OUT: R11.1; also elsewhere on the board
CH1_ADC: C1.1, R2.2; also elsewhere on the board
CH1_CLAMP: D1.3 (K1/A2), R1.2, R2.1
CH1_E: J1.1, R1.1
CH1_N: C1.2, R10.2; also elsewhere on the board
CH2_ADC: C2.1, R4.2; also elsewhere on the board
CH2_CLAMP: D2.3 (K1/A2), R3.2, R4.1
CH2_E: J1.2, R3.1
CH2_N: C2.2, R34.2; also elsewhere on the board
CH3_ADC: C3.1, R6.2; also elsewhere on the board
CH3_CLAMP: D3.3 (K1/A2), R5.2, R6.1
CH3_E: J1.3, R5.1
CH3_N: C3.2, R36.2; also elsewhere on the board
CH4_ADC: C4.1, R8.2; also elsewhere on the board
CH4_CLAMP: D4.3 (K1/A2), R7.2, R8.1
CH4_E: J1.4, R7.1
CH4_N: C4.2, R38.2; also elsewhere on the board
GND: D1.1 (A1), D2.1 (A1), D3.1 (A1), D4.1 (A1), D5.1 (A1), D7.1 (A1), D8.1 (A1), D9.1 (A1); also elsewhere on the board
REF2_CLAMP: D7.3 (K1/A2), R33.2, R34.1
REF3_CLAMP: D8.3 (K1/A2), R35.2, R36.1
REF4_CLAMP: D9.3 (K1/A2), R37.2, R38.1
REF_CLAMP: D5.3 (K1/A2), R9.2, R10.1
REF_E: J1.5, R9.1, R33.1, R35.1, R37.1

Notes on the sheet:
ELECTRODES / INPUT PROTECTION
J1: channels 1-4, reference, bias
Bias electrode: two independent series resistors
CHANNEL 1 / DIFFERENTIAL FILTER
Positive electrode above; shared REF branch below
CHANNEL 2 / DIFFERENTIAL FILTER
CHANNEL 3 / DIFFERENTIAL FILTER
CHANNEL 4 / DIFFERENTIAL FILTER
20 kOhm per input branch / 4.7 nF differential / rail clamps are not a certified patient interface
[I0] REF compares all channels; BIAS is a driven output.
J1 has no circuit-ground electrode. Trace CH1_E to CH1_ADC.
BIAS current path: R11 + R12 = 998 kOhm; bench validation pending.
[I1] R1/R9 limit current toward the clamps; R2/R10 add isolation.
D1/D5: low-leakage rail clamps; leakage creates input offset.
C1 bridges P/N: 40 kOhm differential + 4.7 nF gives about 847 Hz.
This is high-frequency attenuation, not the final EEG bandpass.
[I2] REF_E fans out into four separate protected branches.
Each channel has its own negative input and differential capacitor.
A disturbance on the shared reference can affect several channels.
Channels 3/4 repeat this topology. Clamps do not certify safety.

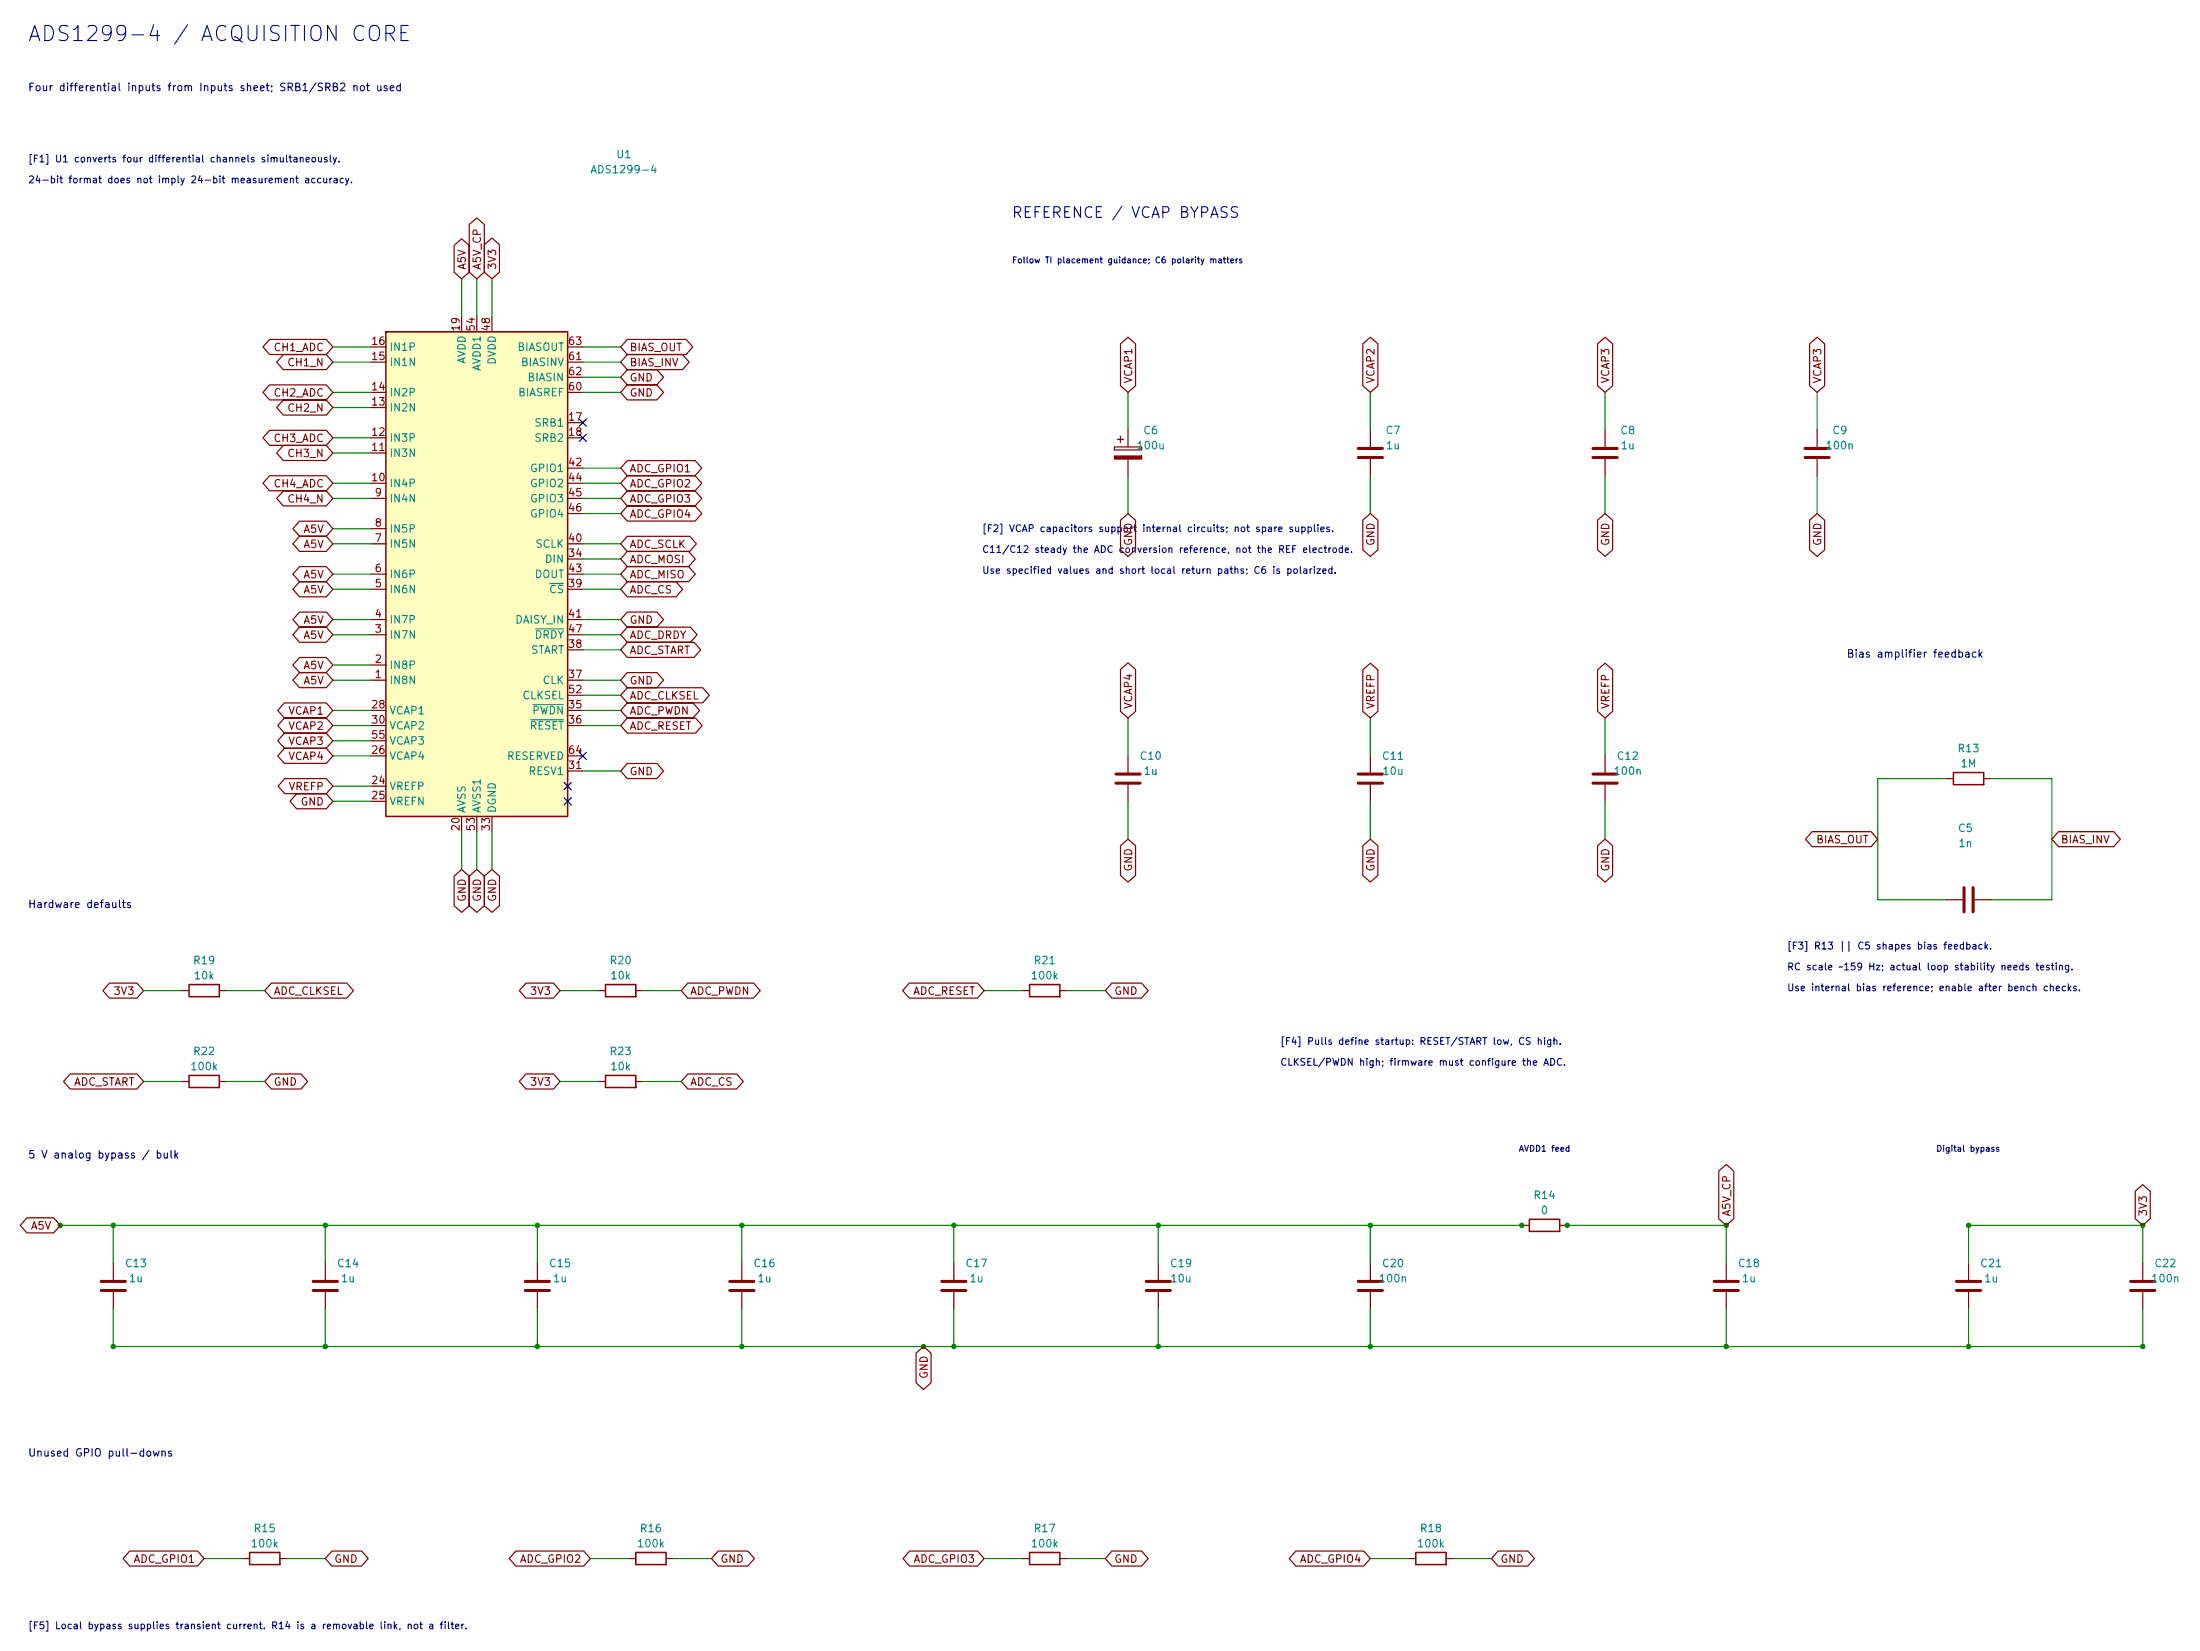
[picture p29: schematic Frontend.kicad_sch, EEG learning prototype - Frontend]

Parts:
C5: 1n; C_0805_2012Metric; MPN GRM21A5C1H102JA01D
C6: 100u; CP_EIA-7343-31_Kemet-D; MPN T491D107K010AT
C7, C8, C10, C13, C14, C15, C16, C17, C18, C21: 1u; C_0805_2012Metric; MPN GRM21BR71E105KA99L
C9, C12, C20, C22: 100n; C_0805_2012Metric; MPN GRM21BR71H104KA01L
C11, C19: 10u; C_1206_3216Metric; MPN GRM31CR71C106KA12L
R13: 1M; R_0805_2012Metric; MPN RC0805FR-071ML
R14: 0; R_0805_2012Metric; MPN RC0805JR-070RL
R15, R16, R17, R18, R21, R22: 100k; R_0805_2012Metric; MPN RC0805FR-07100KL
R19, R20, R23: 10k; R_0805_2012Metric; MPN RC0805FR-0710KL
U1: ADS1299-4; TQFP-64_10x10mm_P0.5mm; MPN ADS1299-4PAG

Connections:
3V3: C21.1, C22.1, R19.1, R20.1, R23.1, U1.48 (DVDD), U1.50 (DVDD); also elsewhere on the board
A5V: C13.1, C14.1, C15.1, C16.1, C17.1, C19.1, C20.1, R14.1, U1.1 (IN8N), U1.2 (IN8P), U1.3 (IN7N), U1.4 (IN7P), U1.5 (IN6N), U1.6 (IN6P), U1.7 (IN5N), U1.8 (IN5P), U1.19 (AVDD), U1.21 (AVDD), U1.22 (AVDD), U1.56 (AVDD), U1.59 (AVDD); also elsewhere on the board
A5V_CP: C18.1, R14.2, U1.54 (AVDD1)
ADC_CLKSEL: R19.2, U1.52 (CLKSEL)
ADC_CS: R23.2, U1.39 (~CS); also elsewhere on the board
ADC_DRDY: U1.47 (~DRDY); also elsewhere on the board
ADC_GPIO1: R15.1, U1.42 (GPIO1)
ADC_GPIO2: R16.1, U1.44 (GPIO2)
ADC_GPIO3: R17.1, U1.45 (GPIO3)
ADC_GPIO4: R18.1, U1.46 (GPIO4)
ADC_MISO: U1.43 (DOUT); also elsewhere on the board
ADC_MOSI: U1.34 (DIN); also elsewhere on the board
ADC_PWDN: R20.2, U1.35 (~PWDN)
ADC_RESET: R21.1, U1.36 (~RESET); also elsewhere on the board
ADC_SCLK: U1.40 (SCLK); also elsewhere on the board
ADC_START: R22.1, U1.38 (START); also elsewhere on the board
BIAS_INV: C5.2, R13.2, U1.61 (BIASINV)
BIAS_OUT: C5.1, R13.1, U1.63 (BIASOUT); also elsewhere on the board
CH1_ADC: U1.16 (IN1P); also elsewhere on the board
CH1_N: U1.15 (IN1N); also elsewhere on the board
CH2_ADC: U1.14 (IN2P); also elsewhere on the board
CH2_N: U1.13 (IN2N); also elsewhere on the board
CH3_ADC: U1.12 (IN3P); also elsewhere on the board
CH3_N: U1.11 (IN3N); also elsewhere on the board
CH4_ADC: U1.10 (IN4P); also elsewhere on the board
CH4_N: U1.9 (IN4N); also elsewhere on the board
GND: C6.2, C7.2, C8.2, C9.2, C10.2, C11.2, C12.2, C13.2, C14.2, C15.2, C16.2, C17.2, C18.2, C19.2, C20.2, C21.2, C22.2, R15.2, R16.2, R17.2, R18.2, R21.2, R22.2, U1.20 (AVSS), U1.23 (AVSS), U1.25 (VREFN), U1.31 (RESV1), U1.32 (AVSS), U1.33 (DGND), U1.37 (CLK), U1.41 (DAISY_IN), U1.49 (DGND), U1.51 (DGND), U1.53 (AVSS1), U1.57 (AVSS), U1.58 (AVSS), U1.60 (BIASREF), U1.62 (BIASIN); also elsewhere on the board
VCAP1: C6.1, U1.28 (VCAP1)
VCAP2: C7.1, U1.30 (VCAP2)
VCAP3: C8.1, C9.1, U1.55 (VCAP3)
VCAP4: C10.1, U1.26 (VCAP4)
VREFP: C11.1, C12.1, U1.24 (VREFP)

Notes on the sheet:
ADS1299-4 / ACQUISITION CORE
Four differential inputs from Inputs sheet; SRB1/SRB2 not used
REFERENCE / VCAP BYPASS
Follow TI placement guidance; C6 polarity matters
Bias amplifier feedback
Hardware defaults
5 V analog bypass / bulk
AVDD1 feed
Digital bypass
Unused GPIO pull-downs
[F1] U1 converts four differential channels simultaneously.
24-bit format does not imply 24-bit measurement accuracy.
[F2] VCAP capacitors support internal circuits; not spare supplies.
C11/C12 steady the ADC conversion reference, not the REF electrode.
Use specified values and short local return paths; C6 is polarized.
[F3] R13 || C5 shapes bias feedback.
RC scale ~159 Hz; actual loop stability needs testing.
Use internal bias reference; enable after bench checks.
[F4] Pulls define startup: RESET/START low, CS high.
CLKSEL/PWDN high; firmware must configure the ADC.
[F5] Local bypass supplies transient current. R14 is a removable link, not a filter.

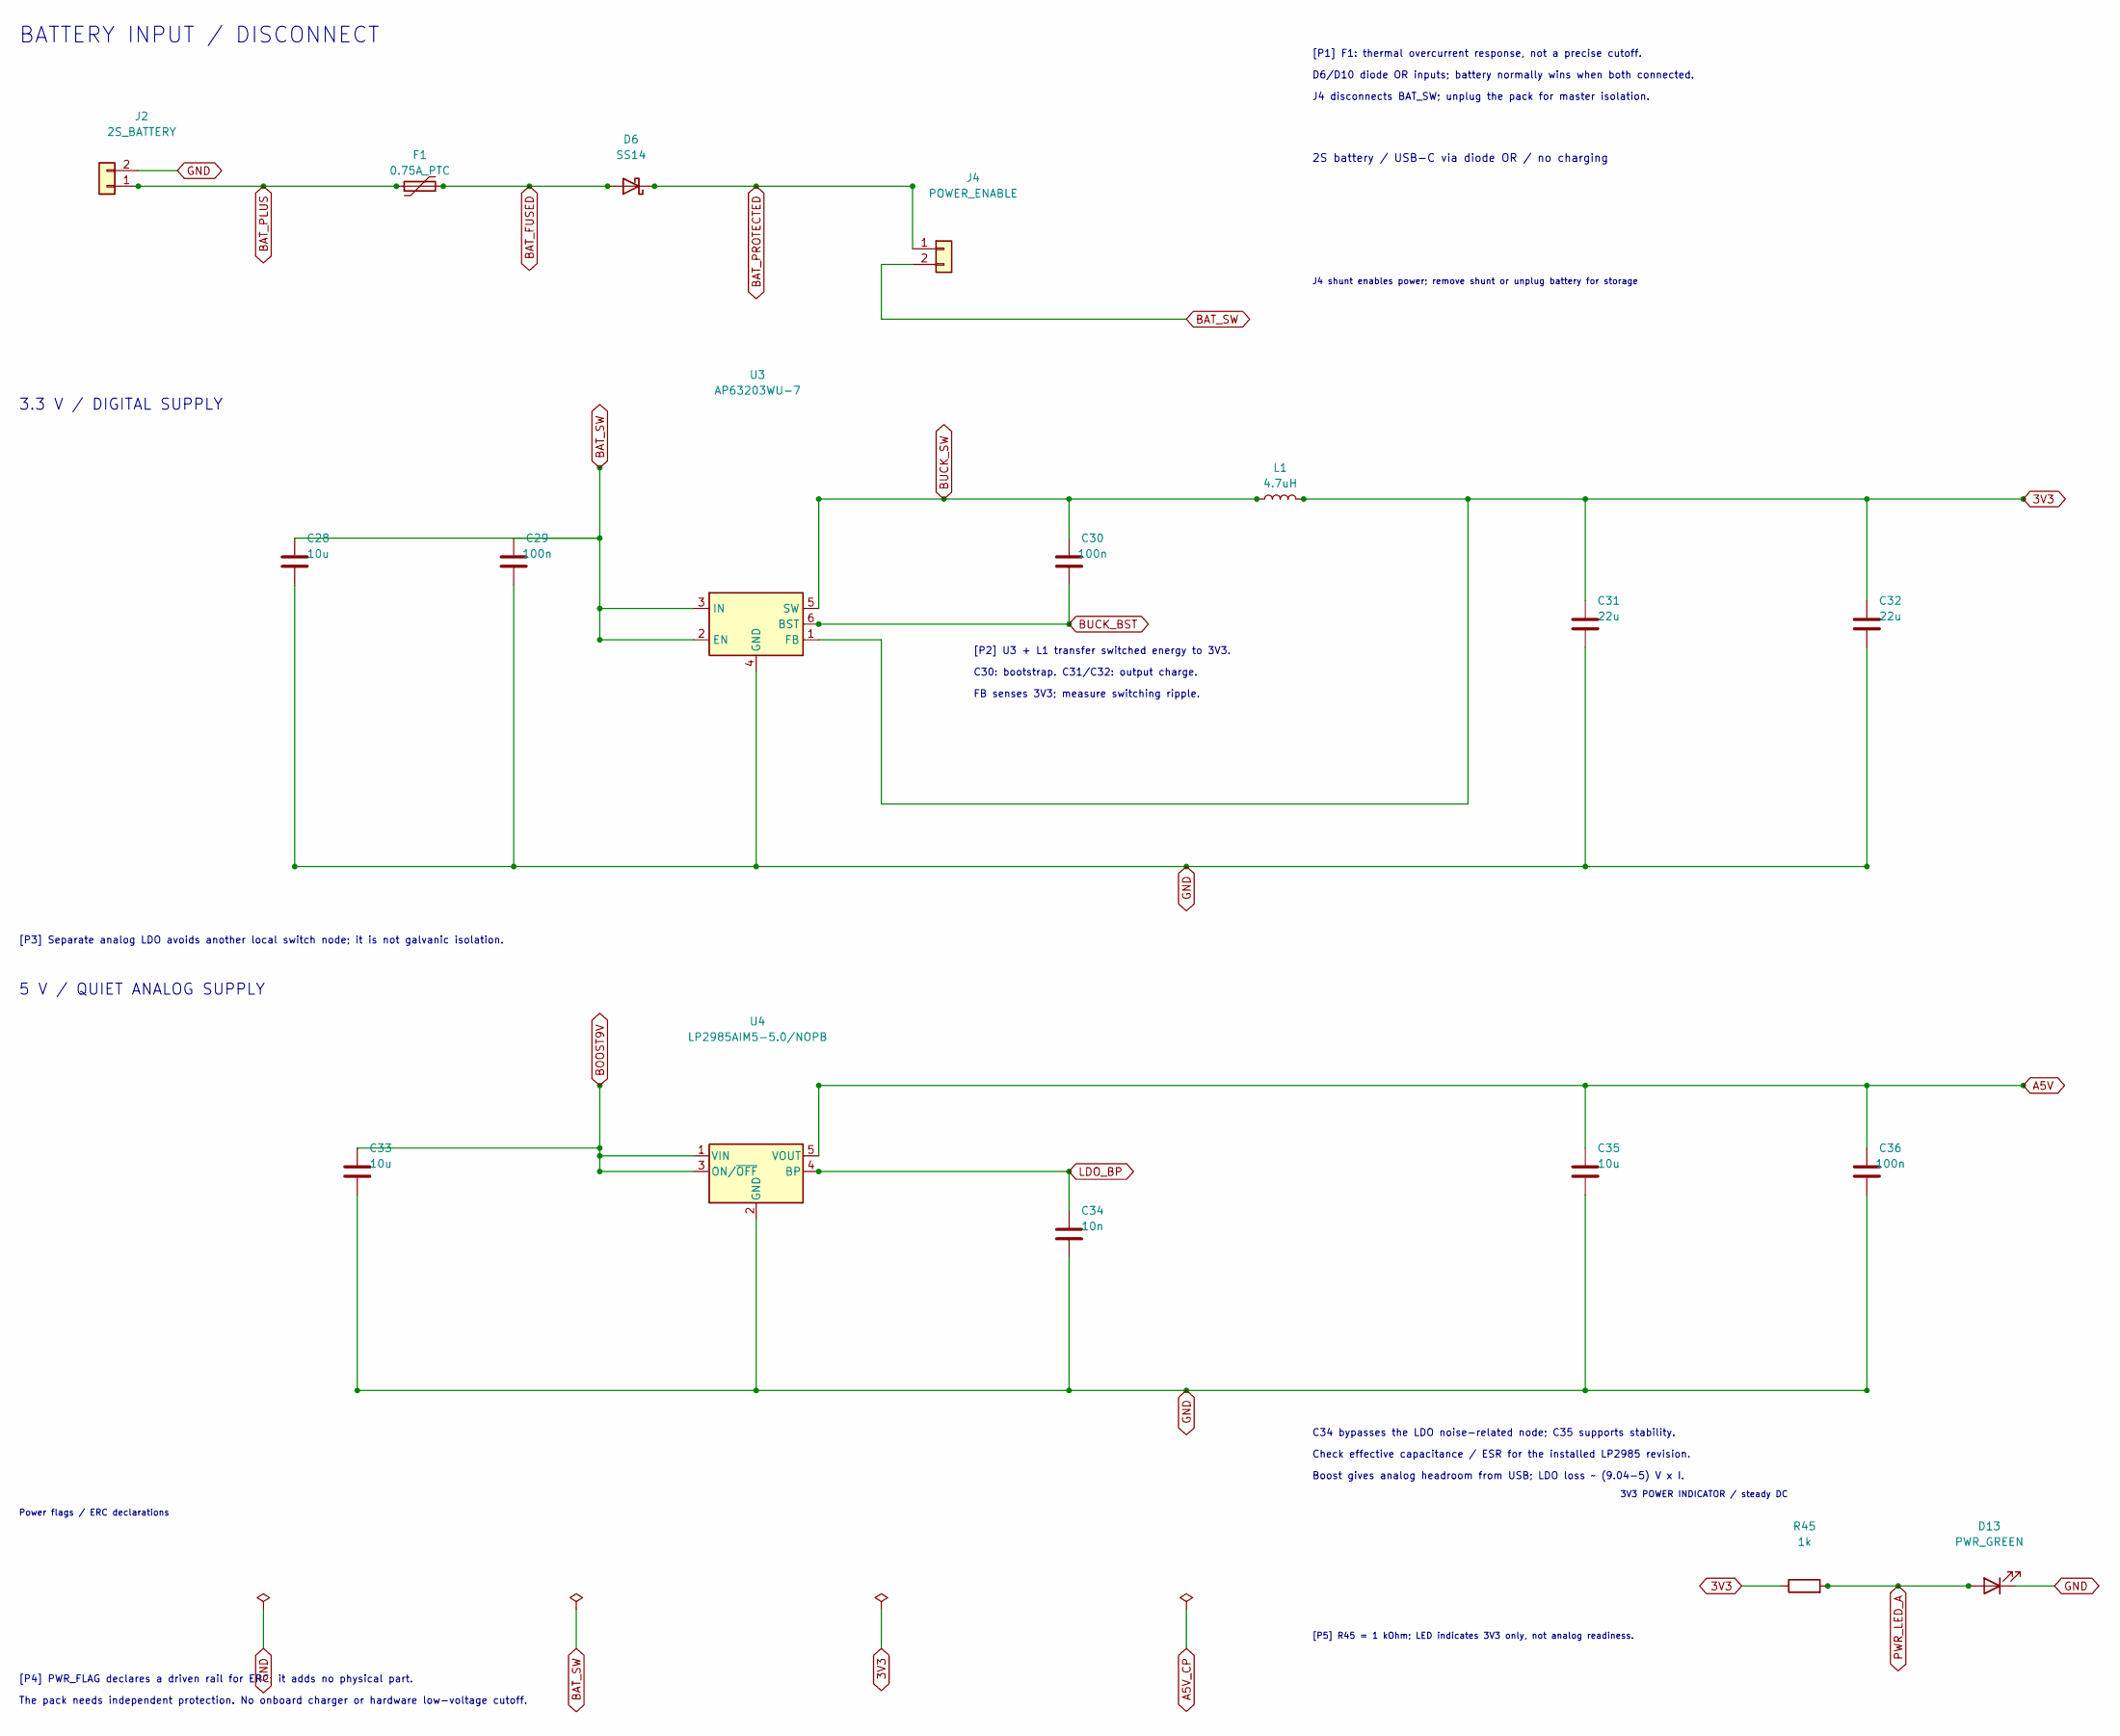
[picture p30: schematic Power.kicad_sch, EEG learning prototype - Power]

Parts:
C28, C33, C35: 10u; C_1206_3216Metric; MPN GRM31CR71C106KA12L
C29, C30, C36: 100n; C_0805_2012Metric; MPN GRM21BR71H104KA01L
C31, C32: 22u; C_1206_3216Metric; MPN GRM31CR61E226KE15L
C34: 10n; C_0805_2012Metric; MPN GRM21A5C1H103JA01D
D6: SS14; D_SMA; MPN SS14
D13: PWR_GREEN; LED_0805_2012Metric; MPN APT2012LZGCK
F1: 0.75A_PTC; Fuse_1812_4532Metric; MPN 1812L075/24DR
J2: 2S_BATTERY; JST_XH_B2B-XH-A_1x02_P2.50mm_Vertical; MPN B2B-XH-A
J4: POWER_ENABLE; PinHeader_1x02_P2.54mm_Vertical; MPN 61300211121
L1: 4.7uH; L_Bourns_SRP5030T; MPN SRP5030T-4R7M
R45: 1k; R_0805_2012Metric; MPN RC0805FR-071KL
U3: AP63203WU-7; TSOT-23-6; MPN AP63203WU-7
U4: LP2985AIM5-5.0/NOPB; SOT-23-5; MPN LP2985AIM5-5.0/NOPB

Connections:
3V3: C31.1, C32.1, L1.2, R45.1, U3.1 (FB); also elsewhere on the board
A5V: C35.1, C36.1, U4.5 (VOUT); also elsewhere on the board
BAT_FUSED: D6.2 (A), F1.2
BAT_PLUS: F1.1, J2.1
BAT_PROTECTED: D6.1 (K), J4.1; also elsewhere on the board
BAT_SW: C28.1, C29.1, J4.2, U3.2 (EN), U3.3 (IN); also elsewhere on the board
BOOST9V: C33.1, U4.1 (VIN), U4.3 (ON/~OFF); also elsewhere on the board
BUCK_BST: C30.1, U3.6 (BST)
BUCK_SW: C30.2, L1.1, U3.5 (SW)
GND: C28.2, C29.2, C31.2, C32.2, C33.2, C34.2, C35.2, C36.2, D13.1 (K), J2.2, U3.4 (GND), U4.2 (GND); also elsewhere on the board
LDO_BP: C34.1, U4.4 (BP)
PWR_LED_A: D13.2 (A), R45.2

Notes on the sheet:
BATTERY INPUT / DISCONNECT
2S battery / USB-C via diode OR / no charging
3.3 V / DIGITAL SUPPLY
5 V / QUIET ANALOG SUPPLY
Power flags / ERC declarations
3V3 POWER INDICATOR / steady DC
[P5] R45 = 1 kOhm; LED indicates 3V3 only, not analog readiness.
J4 shunt enables power; remove shunt or unplug battery for storage
[P1] F1: thermal overcurrent response, not a precise cutoff.
D6/D10 diode OR inputs; battery normally wins when both connected.
J4 disconnects BAT_SW; unplug the pack for master isolation.
[P2] U3 + L1 transfer switched energy to 3V3.
C30: bootstrap. C31/C32: output charge.
FB senses 3V3; measure switching ripple.
[P3] Separate analog LDO avoids another local switch node; it is not galvanic isolation.
C34 bypasses the LDO noise-related node; C35 supports stability.
Check effective capacitance / ESR for the installed LP2985 revision.
Boost gives analog headroom from USB; LDO loss ~ (9.04-5) V x I.
[P4] PWR_FLAG declares a driven rail for ERC; it adds no physical part.
The pack needs independent protection. No onboard charger or hardware low-voltage cutoff.

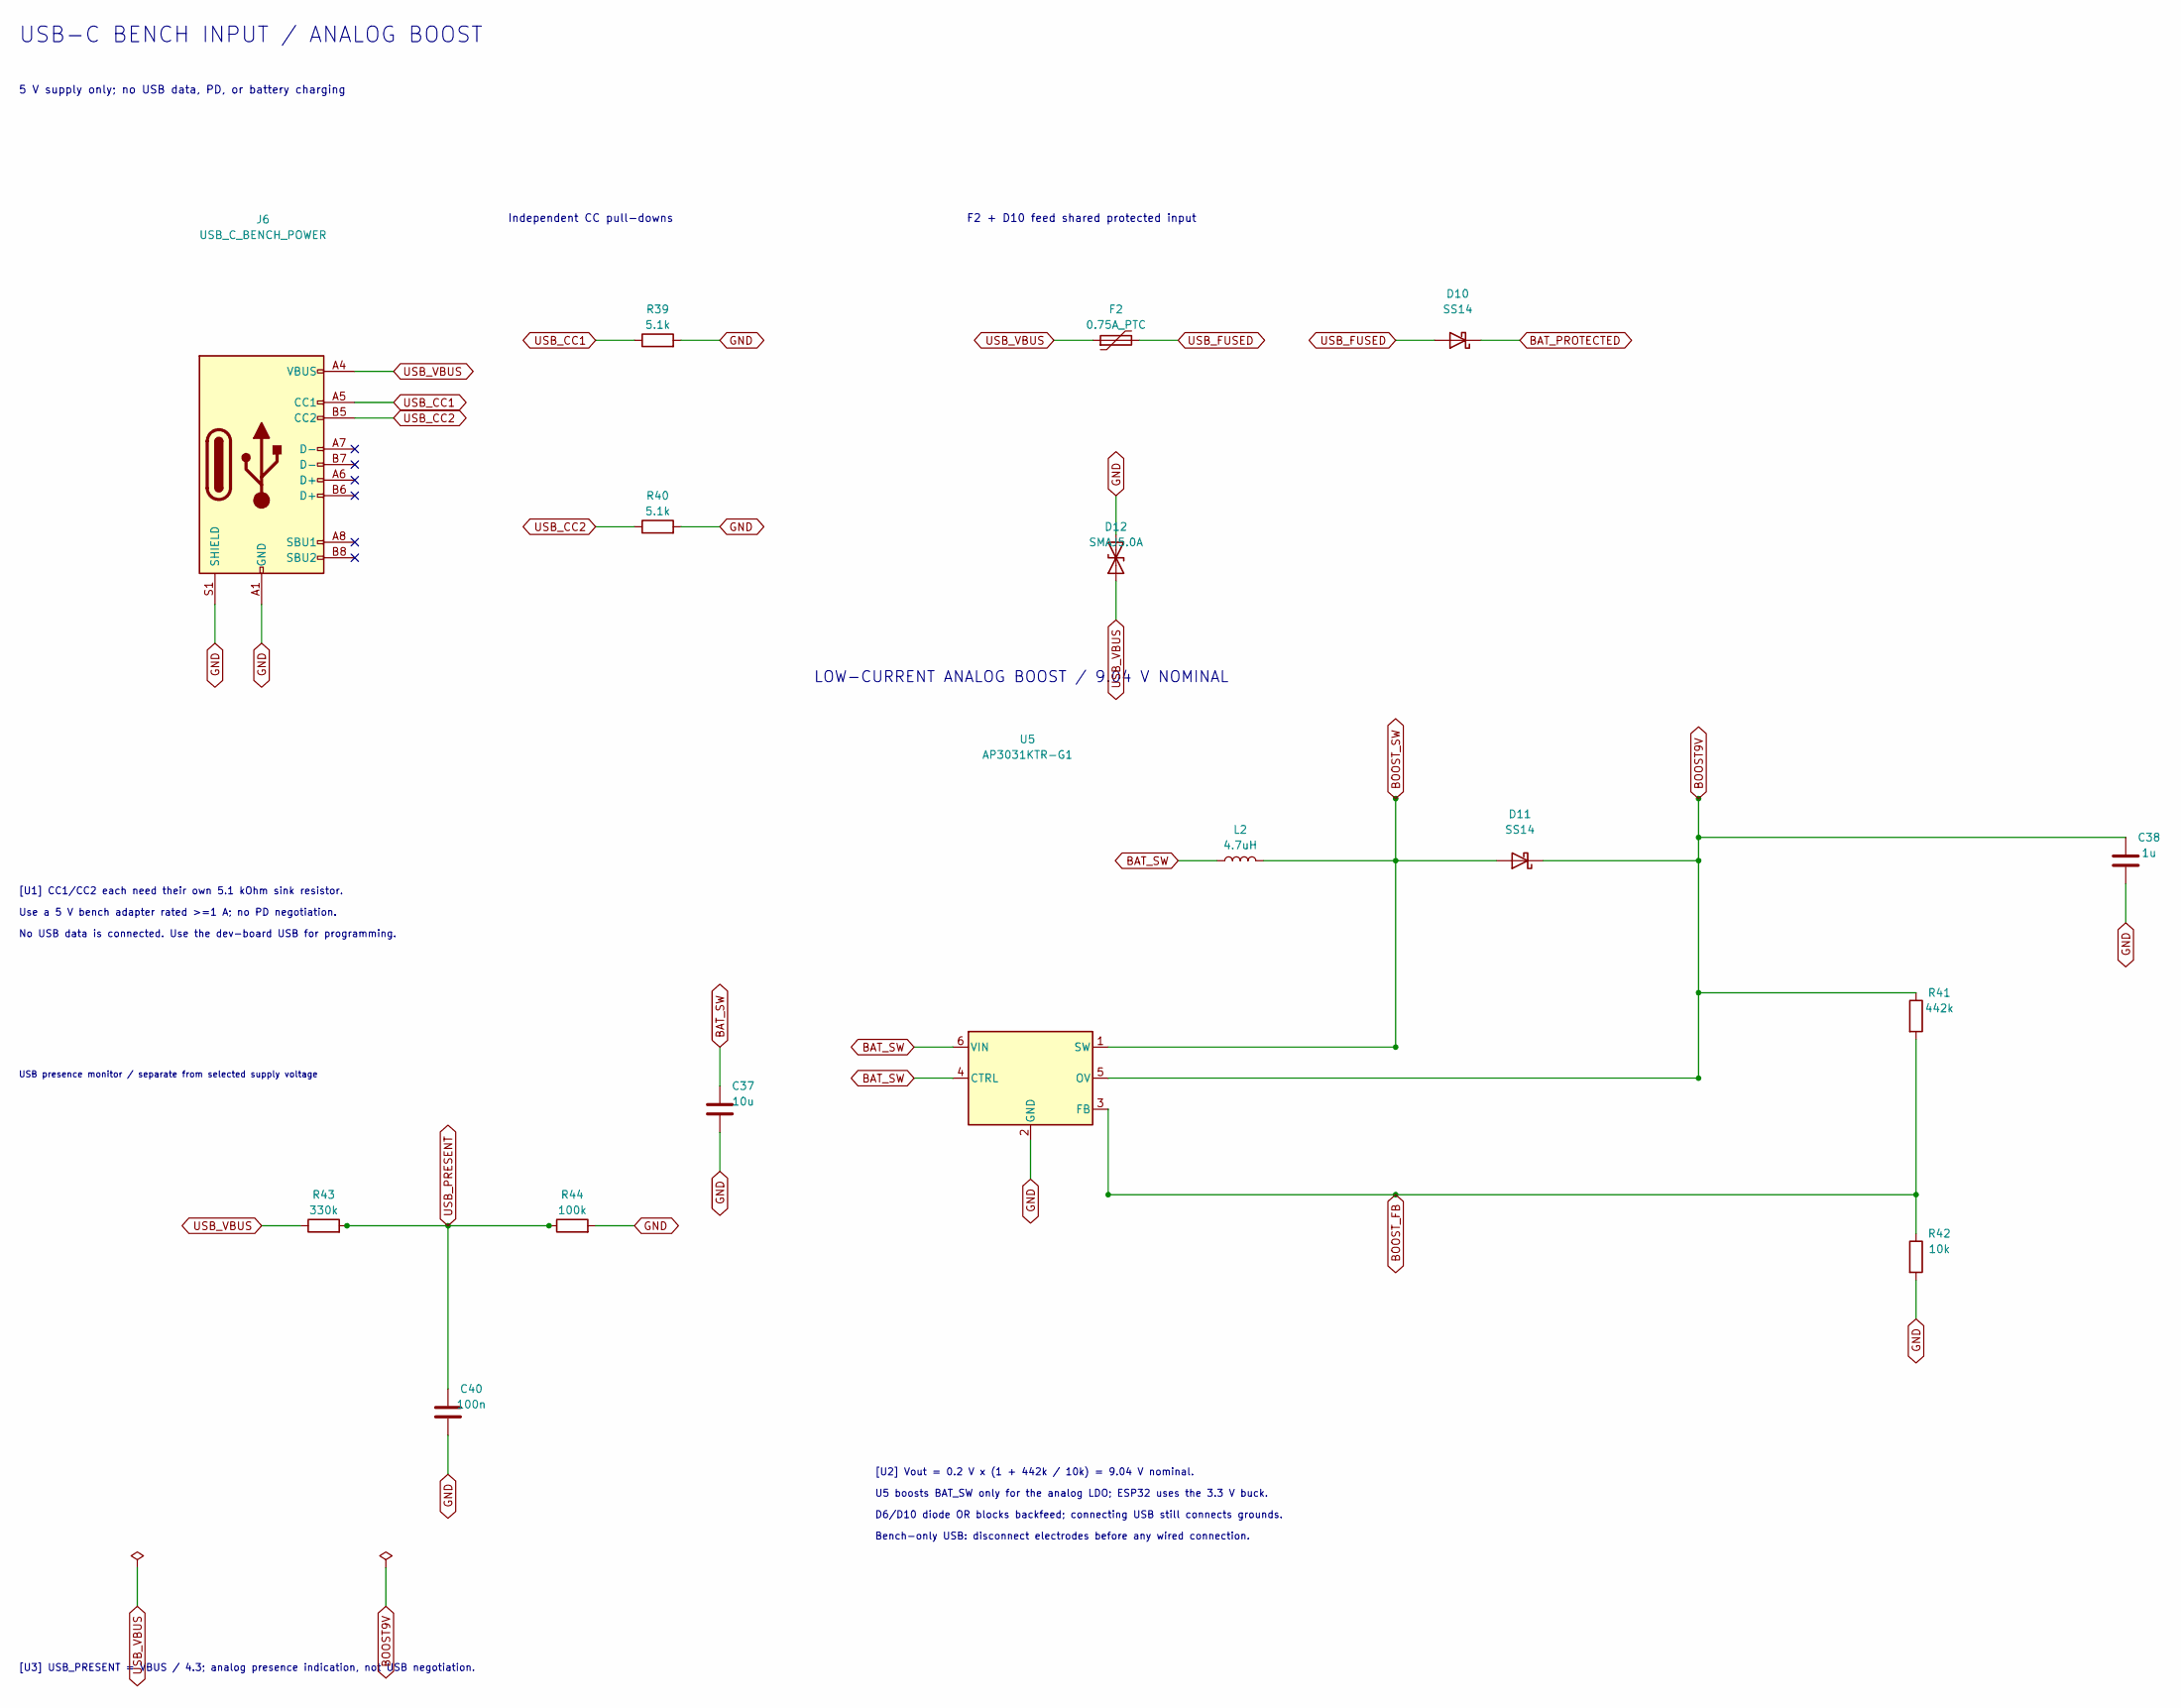
[picture p31: schematic USB.kicad_sch, EEG learning prototype - USB]

Parts:
C37: 10u; C_1206_3216Metric; MPN GRM31CR71C106KA12L
C38: 1u; C_0805_2012Metric; MPN GRM21BR71E105KA99L
C40: 100n; C_0805_2012Metric; MPN GRM21BR71H104KA01L
D10, D11: SS14; D_SMA; MPN SS14
D12: SMAJ5.0A; D_SMA; MPN SMAJ5.0A
F2: 0.75A_PTC; Fuse_1812_4532Metric; MPN 1812L075/24DR
J6: USB_C_BENCH_POWER; USB_C_Receptacle_GCT_USB4105-xx-A_16P_TopMnt_Horizontal; MPN USB4105-GF-A
L2: 4.7uH; L_Bourns_SRP5030T; MPN SRP5030T-4R7M
R39, R40: 5.1k; R_0805_2012Metric; MPN RC0805FR-075K1L
R41: 442k; R_0805_2012Metric; MPN RC0805FR-07442KL
R42: 10k; R_0805_2012Metric; MPN RC0805FR-0710KL
R43: 330k; R_0805_2012Metric; MPN RC0805FR-07330KL
R44: 100k; R_0805_2012Metric; MPN RC0805FR-07100KL
U5: AP3031KTR-G1; SOT-23-6; MPN AP3031KTR-G1

Connections:
BAT_PROTECTED: D10.1 (K); also elsewhere on the board
BAT_SW: C37.1, L2.1, U5.4 (CTRL), U5.6 (VIN); also elsewhere on the board
BOOST9V: C38.1, D11.1 (K), R41.1, U5.5 (OV); also elsewhere on the board
BOOST_FB: R41.2, R42.1, U5.3 (FB)
BOOST_SW: D11.2 (A), L2.2, U5.1 (SW)
GND: C37.2, C38.2, C40.2, D12.2 (A2), J6.A1 (GND), J6.A12 (GND), J6.B1 (GND), J6.B12 (GND), J6.S1 (SHIELD), R39.2, R40.2, R42.2, R44.2, U5.2 (GND); also elsewhere on the board
USB_CC1: J6.A5 (CC1), R39.1
USB_CC2: J6.B5 (CC2), R40.1
USB_FUSED: D10.2 (A), F2.2
USB_PRESENT: C40.1, R43.2, R44.1; also elsewhere on the board
USB_VBUS: D12.1 (A1), F2.1, J6.A4 (VBUS), J6.A9 (VBUS), J6.B4 (VBUS), J6.B9 (VBUS), R43.1

Notes on the sheet:
USB-C BENCH INPUT / ANALOG BOOST
5 V supply only; no USB data, PD, or battery charging
Independent CC pull-downs
F2 + D10 feed shared protected input
LOW-CURRENT ANALOG BOOST / 9.04 V NOMINAL
USB presence monitor / separate from selected supply voltage
[U1] CC1/CC2 each need their own 5.1 kOhm sink resistor.
Use a 5 V bench adapter rated >=1 A; no PD negotiation.
No USB data is connected. Use the dev-board USB for programming.
[U2] Vout = 0.2 V x (1 + 442k / 10k) = 9.04 V nominal.
U5 boosts BAT_SW only for the analog LDO; ESP32 uses the 3.3 V buck.
D6/D10 diode OR blocks backfeed; connecting USB still connects grounds.
Bench-only USB: disconnect electrodes before any wired connection.
[U3] USB_PRESENT = VBUS / 4.3; analog presence indication, not USB negotiation.
