mhyrzt/agentronics/EEG/hardware/EEG.kicad_pcb

## KiCad design EEG/hardware/EEG.kicad_pcb (continued)

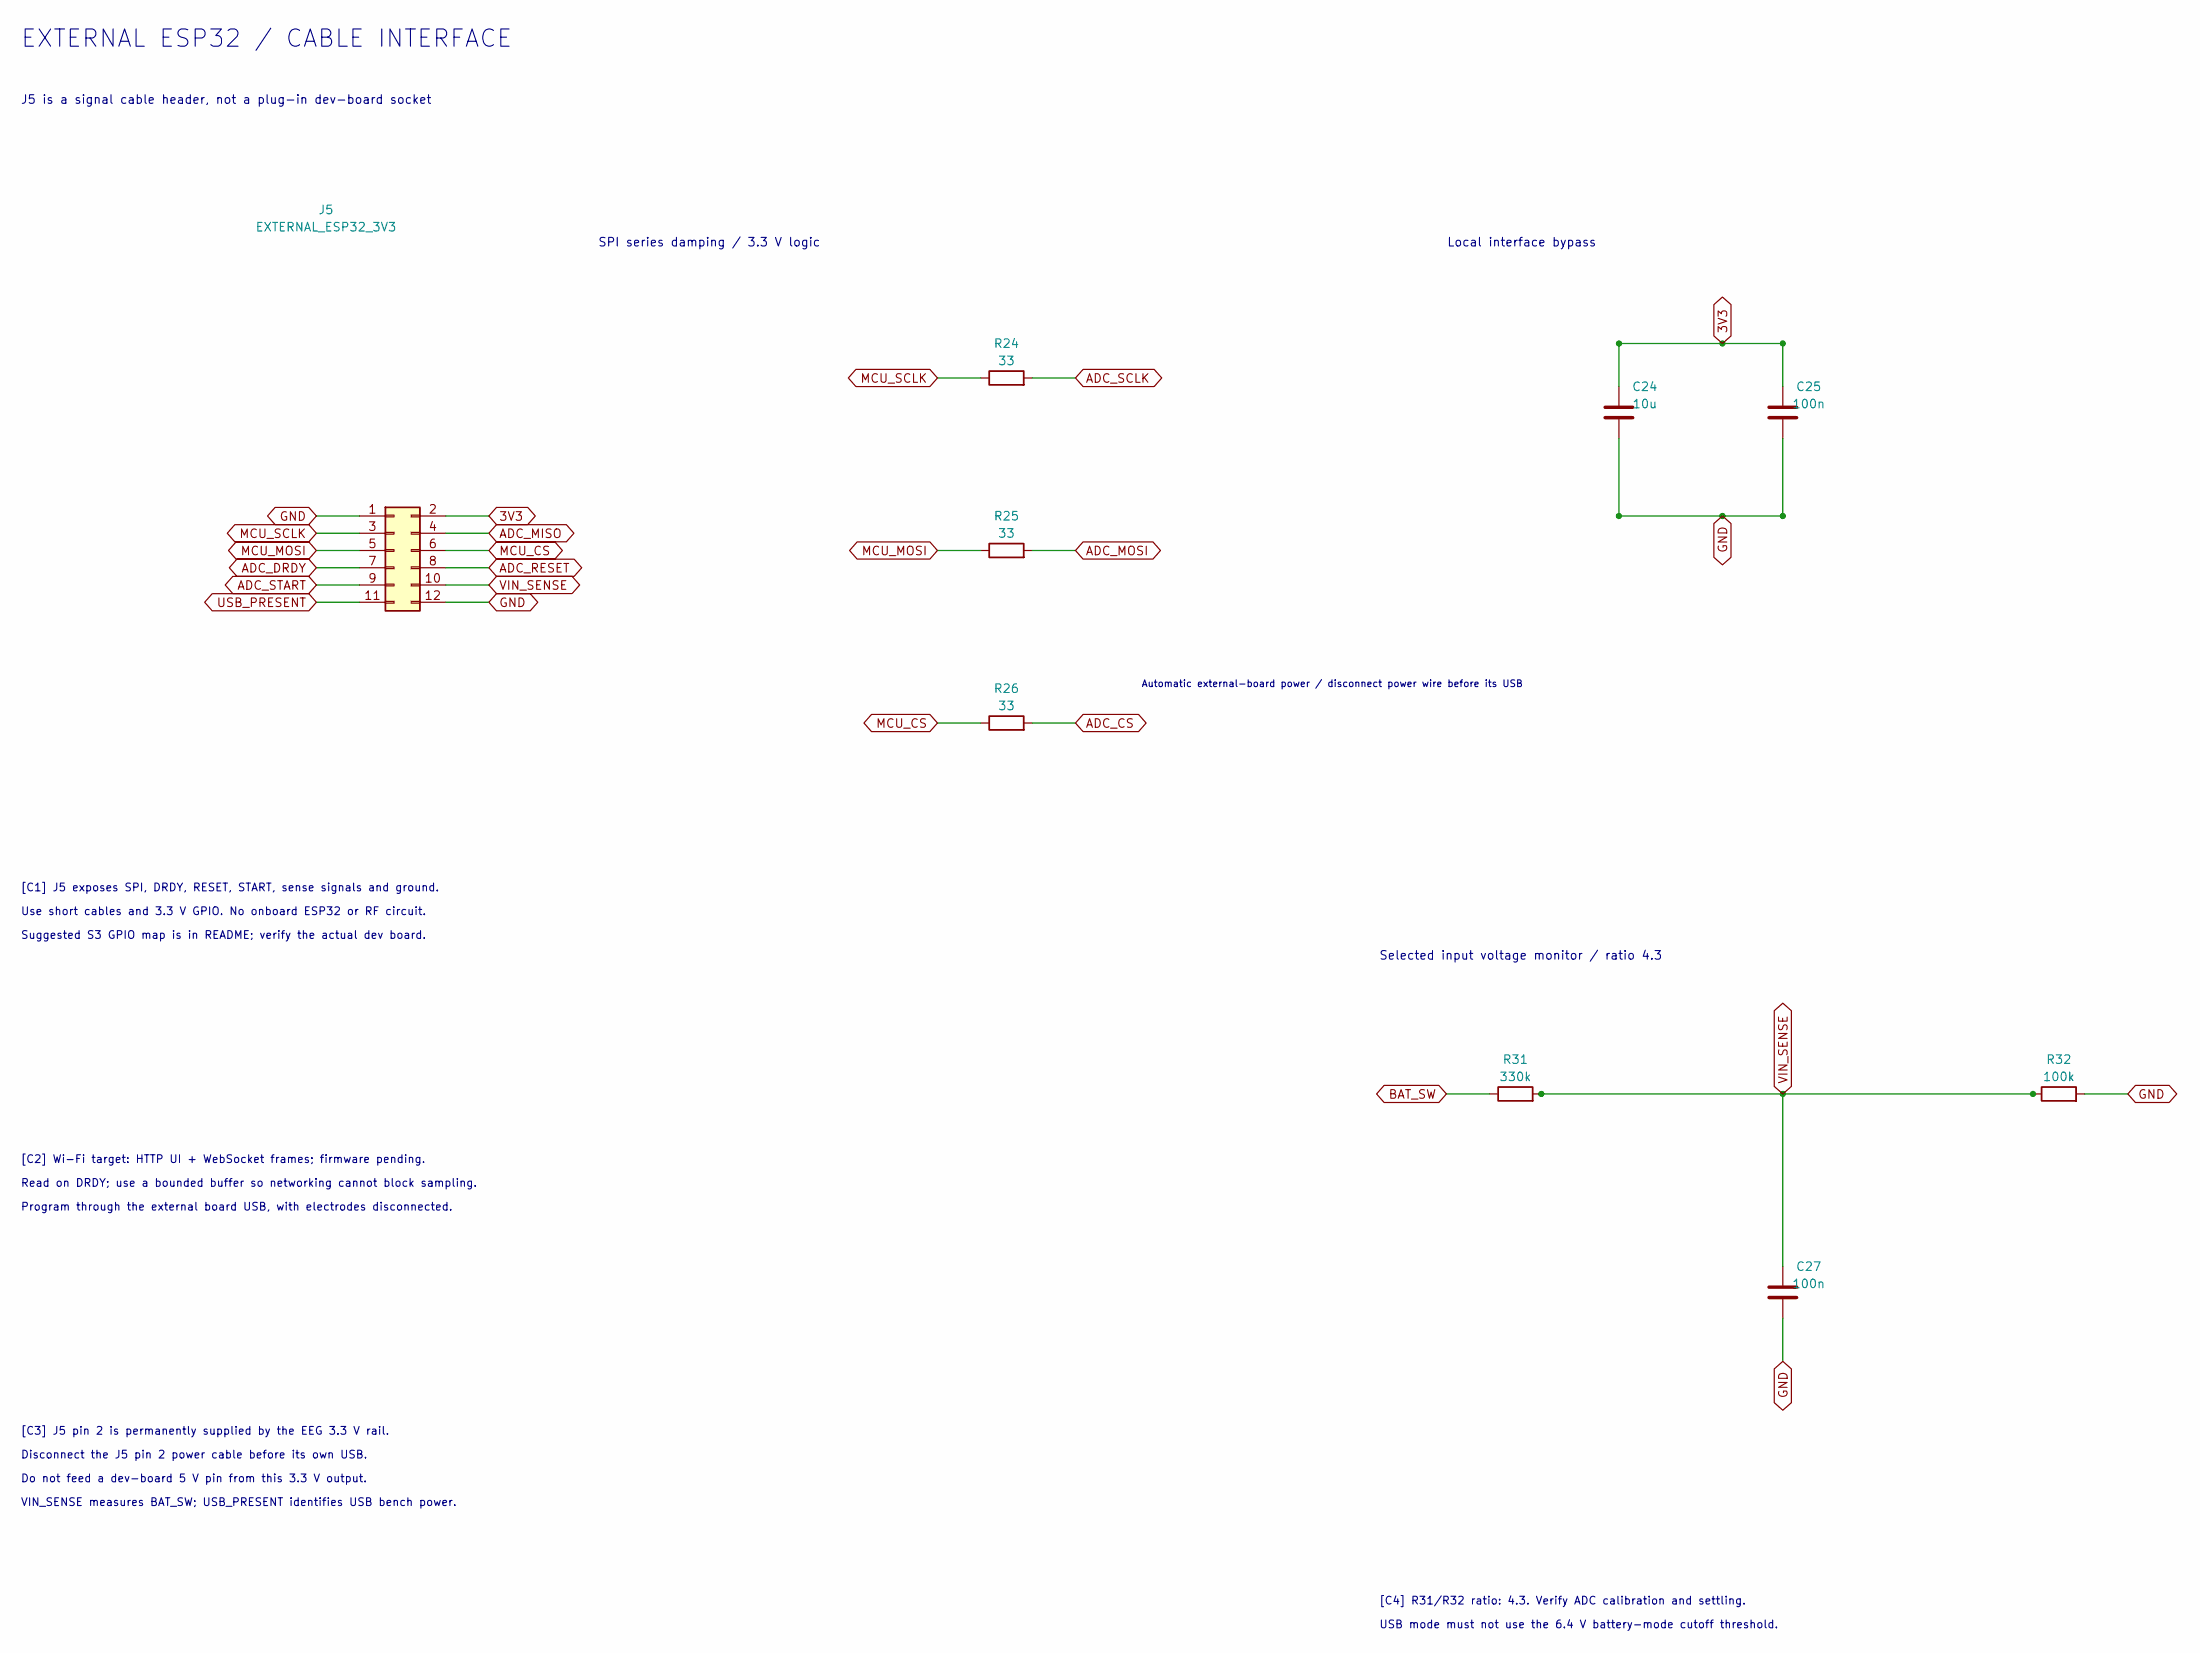
[picture p32: schematic Controller.kicad_sch, EEG learning prototype - Controller]

Parts:
C24: 10u; C_1206_3216Metric; MPN GRM31CR71C106KA12L
C25, C27: 100n; C_0805_2012Metric; MPN GRM21BR71H104KA01L
J5: EXTERNAL_ESP32_3V3; PinHeader_2x06_P2.54mm_Vertical; MPN 61301221121
R24, R25, R26: 33; R_0805_2012Metric; MPN RC0805FR-0733RL
R31: 330k; R_0805_2012Metric; MPN RC0805FR-07330KL
R32: 100k; R_0805_2012Metric; MPN RC0805FR-07100KL

Connections:
3V3: C24.1, C25.1, J5.2; also elsewhere on the board
ADC_CS: R26.2; also elsewhere on the board
ADC_DRDY: J5.7; also elsewhere on the board
ADC_MISO: J5.4; also elsewhere on the board
ADC_MOSI: R25.2; also elsewhere on the board
ADC_RESET: J5.8; also elsewhere on the board
ADC_SCLK: R24.2; also elsewhere on the board
ADC_START: J5.9; also elsewhere on the board
BAT_SW: R31.1; also elsewhere on the board
GND: C24.2, C25.2, C27.2, J5.1, J5.12, R32.2; also elsewhere on the board
MCU_CS: J5.6, R26.1
MCU_MOSI: J5.5, R25.1
MCU_SCLK: J5.3, R24.1
USB_PRESENT: J5.11; also elsewhere on the board
VIN_SENSE: C27.1, J5.10, R31.2, R32.1

Notes on the sheet:
EXTERNAL ESP32 / CABLE INTERFACE
J5 is a signal cable header, not a plug-in dev-board socket
SPI series damping / 3.3 V logic
Local interface bypass
Automatic external-board power / disconnect power wire before its USB
Selected input voltage monitor / ratio 4.3
[C1] J5 exposes SPI, DRDY, RESET, START, sense signals and ground.
Use short cables and 3.3 V GPIO. No onboard ESP32 or RF circuit.
Suggested S3 GPIO map is in README; verify the actual dev board.
[C2] Wi-Fi target: HTTP UI + WebSocket frames; firmware pending.
Read on DRDY; use a bounded buffer so networking cannot block sampling.
Program through the external board USB, with electrodes disconnected.
[C3] J5 pin 2 is permanently supplied by the EEG 3.3 V rail.
Disconnect the J5 pin 2 power cable before its own USB.
Do not feed a dev-board 5 V pin from this 3.3 V output.
VIN_SENSE measures BAT_SW; USB_PRESENT identifies USB bench power.
[C4] R31/R32 ratio: 4.3. Verify ADC calibration and settling.
USB mode must not use the 6.4 V battery-mode cutoff threshold.

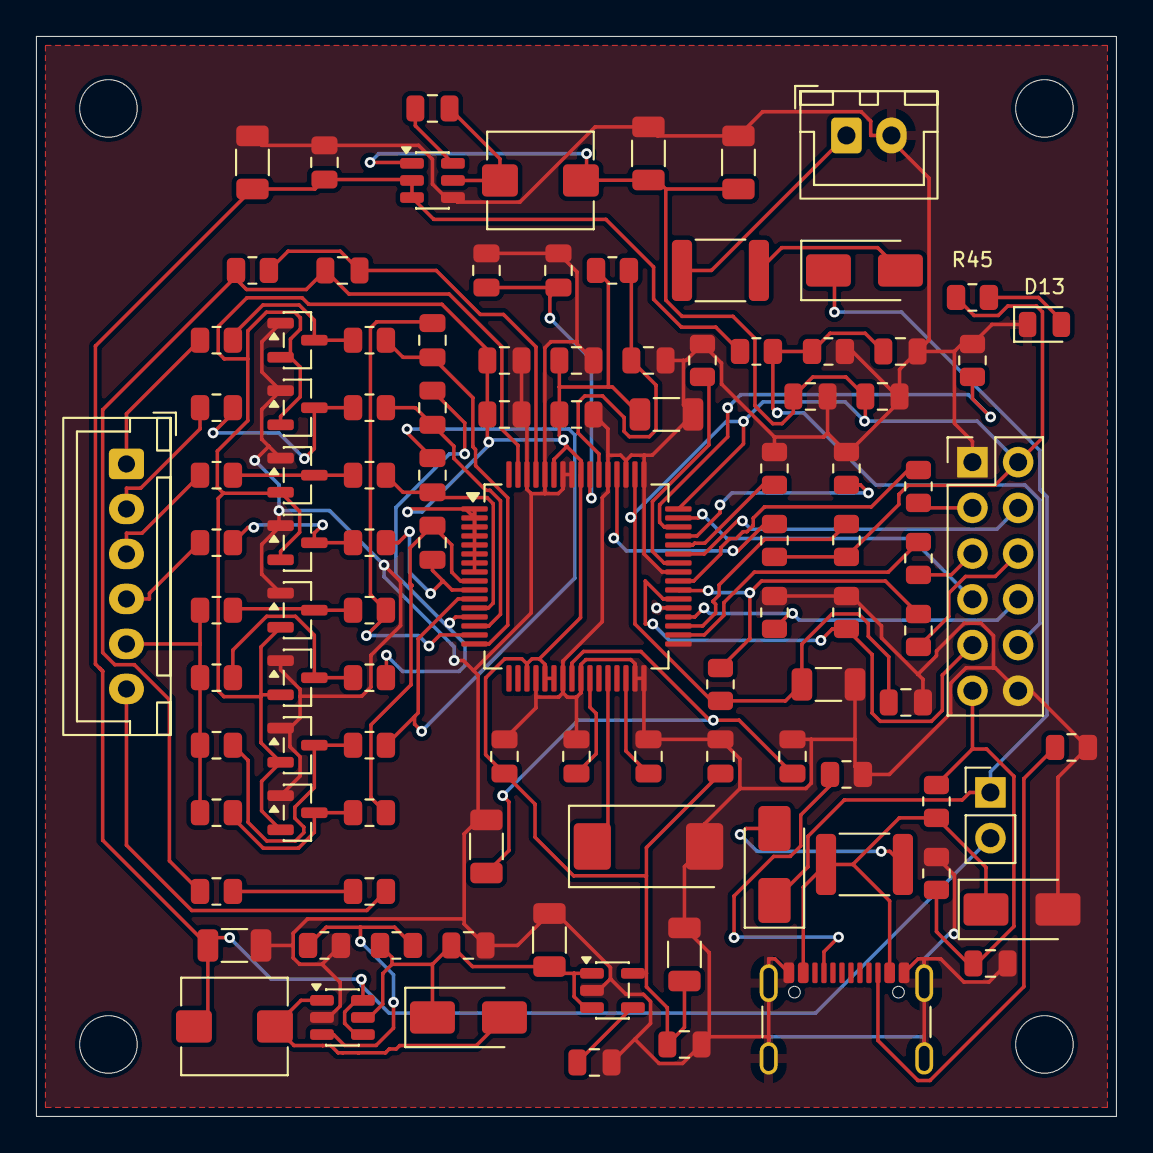
[picture p33: board EEG.kicad_pcb from above]

Board: 2 copper layers, 60.0 x 60.0 mm, 108 parts (0 on the bottom side), 67 nets.

Other parts of the board:
MH1, MH2, MH3, MH4: MountingHole_3.2mm; MountingHole_3.2mm_M3
