mhyrzt/agentronics/(commit log)

2026-10-12 feat(eeg): add four-channel EEG hardware
    [Controller.kicad_sch, EEG.kicad_pcb, EEG.kicad_sch, Frontend.kicad_sch, Inputs.kicad_sch, Power.kicad_sch, USB.kicad_sch]
2026-10-12 chore(eeg): retain previews and Rev A exports
    [BOM.csv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]
2026-10-12 docs(eeg): explain circuits and component costs
2026-10-13 feat(eeg): compact and center PCB, add power LED
    [Controller.kicad_sch, EEG.kicad_pcb, Power.kicad_sch]
2026-10-13 chore(eeg): update layout tools and CAD checks
2026-10-13 docs(eeg): clarify parts and power connections
2026-10-13 chore(eeg): refresh previews and release packages
    [BOM.csv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]
